SiDu01/MakroPad/hardware/case/README.md

# MakroPad Gehäuse

Parametrisches OpenSCAD-Modell: [makropad_case.scad](makropad_case.scad).

- Deckel ca. 199 × 117 mm, 12° Neigung (vorne 17 mm, hinten 42 mm hoch), überstehender Rand 5 mm hoch.
- 16 Tasten im 5×4-Raster, oben rechts ersetzt das OLED einen 2×2-Block, 3 Slider rechts.
- Switches sitzen in einer 7.5 mm tiefen Mulde (eigenes Druckteil), sichtbar sind nur die Keycaps.
- Die Schale ist gegenüber dem Deckel eingezogen (8 mm seitlich, 5 mm vorne/hinten),
  darunter verjüngt sie sich in Facetten zu einer achteckigen Bodenfläche.
- OLED in einem keilförmigen Gehäuse auf dem 2×2-Block: Display steht 60° zum Tisch,
  ragt ca. 25 mm über den Deckel.
- Deckel 5 mm stark, Kanten rechtwinklig zur Oberfläche.
- ESP32 liegt quer unter den Slidern an der Rückwand, flach über dem Boden, USB-C geht rechts aus dem Gehäuse.

## Teile & Export

| Teil | Druckausrichtung |
| --- | --- |
| `lid` | Sichtseite auf dem Bett (automatisch flach gelegt) |
| `switch_plate` | Platte auf dem Bett |
| `tray` | Boden auf dem Bett |
| `oled_frame` | aufrecht, Zapfen auf dem Bett; z. B. Silk-Silber-PLA |
| Keycap ([makropad_keycap.scad](makropad_keycap.scad), 16×) | FDM: aufrecht, offene Unterseite auf dem Bett. SLA: 30–45° gekippt, Oberseite zur Plattform, Stützen nur an Kante/Innenwand |

```powershell
foreach ($p in "lid", "switch_plate", "tray", "oled_frame") {
  & "D:\Program Files\OpenSCAD\openscad.exe" -D "part=""$p""" -o "export\makropad_$p.stl" makropad_case.scad
}
```

`part` = `assembly` | `exploded` | `lid` | `switch_plate` | `tray` | `oled_frame`.
Keycap (MX-Kreuz, blanko, flach mit leichter Mulde), `printer` = `fdm` | `sla` wählt das Spiel im Kreuz:

```powershell
foreach ($p in "fdm", "sla") {
  & "D:\Program Files\OpenSCAD\openscad.exe" -D "printer=""$p""" -o "export\makropad_keycap_$p.stl" makropad_keycap.scad
}
```

Sitzt die Kappe zu stramm oder zu locker, `cross_fdm` bzw. `cross_sla` anpassen.
FDM zeigt auf der gewölbten Oberseite Schichtstufen; für eine glatte Oberfläche SLA nehmen
(zähes oder ABS-ähnliches Resin, Kreuz vor dem Nachhärten freimachen).

Alle Maße stehen oben in der Datei (im OpenSCAD-Customizer editierbar).
Werte mit `NACHMESSEN` sind Annahmen.

Keines der Teile braucht Stützen. PLA/PETG, 0.2 mm Schicht, 3–4 Wände
(die Switch-Clips halten an 1.5 mm Plattenstärke).

## Montage

1. Switches von oben in die Switch-Platte klicken.
2. Switch-Platte von unten in den Deckel setzen, 4× M2×6 durch die Laschen in den Deckel.
3. OLED kopfüber einbauen (Anschlüsse unten, die Firmware dreht das Bild per
   `config::OledRotation`): von unten in das Display-Gehäuse führen, an die schräge
   Fläche legen und ca. 2,5 mm nach oben schieben, bis der obere Platinenrand unter
   der Haltelippe steckt. Unten mit 2× M1.7×4 durch die Platine verschrauben
   (Schraubendreher schräg von unten durch die offene Unterseite).
   Keine Stiftleiste auf der Display-Seite → Kabel direkt anlöten, sie laufen nach unten raus.
   Rahmen samt Display von oben in den Deckel setzen und mit 2× M1.7×5 von unten durch
   die Auflage im Deckel verschrauben.
4. Slider-Module von unten an die Abstandshalter schrauben (M3, selbstschneidend).
   Das Poti sitzt außermittig: der schmale 2-mm-Rand neben dem Poti zeigt nach rechts
   (zur Außenkante), sonst trifft der Hebel den Schlitz nicht.
   Stiftleisten möglichst seitlich/abgewinkelt, nach unten ist wenig Platz.
5. ESP32 (64 × 28 mm, schmales Ende 18 mm) ohne Stiftleisten: Kabel direkt in die Lötaugen
   löten, Lötstellen unten max. 1,5 mm. Board in die Halterung unter den Slidern legen,
   USB-C zur rechten Seitenwand, das schmale Ende links in den Anschlag. Über dem Board
   bleiben ca. 10 mm bis zur Unterseite der Slider-Module.
6. Deckel aufsetzen, bis die 4 Schnapphaken (rechts und hinten) einrasten, dann
   5× M2×10 Zylinderkopf (DIN 912) von unten durch die Kanäle der Schale in die Dome
   am Deckel schrauben (vorne links, hinten links, vorne und hinten zwischen Tasten und
   Slidern, hinten neben dem OLED).
