SiDu01/MakroPad/graphify-out/GRAPH_REPORT.md

# Graph Report - MakroPad  (2026-11-03)

## Corpus Check
- 133 files · ~69,151 words
- Verdict: corpus is large enough that graph structure adds value.

## Summary
- 3484 nodes · 4950 edges · 336 communities (242 shown, 94 thin omitted)
- Extraction: 98% EXTRACTED · 2% INFERRED · 0% AMBIGUOUS · INFERRED: 88 edges (avg confidence: 0.8)
- Token cost: 0 input · 0 output

## Graph Freshness
- Built from commit: `afa39b66`
- Run `git rev-parse HEAD` and compare to check if the graph is stale.
- Run `graphify update .` after code changes (no API cost).

## Community Hubs (Navigation)
- [[_COMMUNITY_Community 0|Community 0]]
- [[_COMMUNITY_Community 1|Community 1]]
- [[_COMMUNITY_Community 3|Community 3]]
- [[_COMMUNITY_Community 4|Community 4]]
- [[_COMMUNITY_Community 6|Community 6]]
- [[_COMMUNITY_Community 7|Community 7]]
- [[_COMMUNITY_Community 8|Community 8]]
- [[_COMMUNITY_Community 9|Community 9]]
- [[_COMMUNITY_Community 10|Community 10]]
- [[_COMMUNITY_Community 11|Community 11]]
- [[_COMMUNITY_Community 12|Community 12]]
- [[_COMMUNITY_Community 14|Community 14]]
- [[_COMMUNITY_Community 17|Community 17]]
- [[_COMMUNITY_Community 18|Community 18]]
- [[_COMMUNITY_Community 19|Community 19]]
- [[_COMMUNITY_Community 20|Community 20]]
- [[_COMMUNITY_Community 21|Community 21]]
- [[_COMMUNITY_Community 22|Community 22]]
- [[_COMMUNITY_Community 23|Community 23]]
- [[_COMMUNITY_Community 24|Community 24]]
- [[_COMMUNITY_Community 25|Community 25]]
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
3. `ShellViewModel` - 80 edges
4. `IdleScreensEditorViewModel` - 53 edges
5. `PadViewModel` - 52 edges
6. `MakroPadRuntime` - 42 edges
7. `SerialMakroPadConnection` - 39 edges
8. `DisplaySettingsViewModel` - 37 edges
9. `App` - 36 edges
10. `BindingInspectorViewModel` - 32 edges

## Surprising Connections (you probably didn't know these)
- `MakroPad Firmware` --semantically_similar_to--> `ESP32-S3 Firmware`  [INFERRED] [semantically similar]
  firmware/MakroPadFirmware/README.md → README.md
- `IdleScreenOrchestrator` --references--> `DateTime`  [EXTRACTED]
  legacy/app/MakroPad.App/Services/IdleScreenOrchestrator.cs → app/MakroPad.Core/Display/OledMirror.cs
- `SerialMakroPadConnection` --references--> `SerialPort`  [EXTRACTED]
  legacy/app/MakroPad.Device/SerialMakroPadConnection.cs → app/MakroPad.Device/SerialLineTransport.cs
- `MainWindowViewModel` --references--> `IReadOnlyDictionary`  [EXTRACTED]
  app/MakroPad.App/ViewModels/MainWindowViewModel.cs → legacy/app/MakroPad.App/Services/ActionDefinitionCatalog.cs
- `MainWindowViewModel` --references--> `SimulatedMakroPadConnection`  [EXTRACTED]
  app/MakroPad.App/ViewModels/MainWindowViewModel.cs → legacy/app/MakroPad.App/Services/DeviceSessionService.cs

## Hyperedges (group relationships)
- **Serial Handshake Flow** — protocol_hello_message, protocol_hello_ack_message, app_readme_serial_connection, firmware_readme_makropad_firmware [EXTRACTED 1.00]
- **Input to Action Flow** — hardware_buttons_gpio_pullup, hardware_sliders_adc1, protocol_button_message, protocol_slider_message, app_readme_action_pipeline [EXTRACTED 1.00]
- **OLED Display Configuration Flow** — hardware_oled_i2c_ssd1306, protocol_display_message, protocol_config_message, protocol_action_result_message, app_readme_oled_default_screen [EXTRACTED 1.00]

## Communities (336 total, 94 thin omitted)

### Community 0 - "Community 0"
Cohesion: 0.18
Nodes (19): OLED Default Screen, ActiveSliderCount, Adafruit GFX Library, Adafruit SSD1306 Library, MakroPad Firmware, Wire Library, Buttons GPIO INPUT_PULLUP Wiring, ESP32-S3-DevKitC-1 (+11 more)

### Community 1 - "Community 1"
Cohesion: 0.03
Nodes (34): ActionPipeline, ActionDefinitionCatalog, ActionPipeline, BindingEditorService, bool, CancellationTokenSource, DeviceDisplaySyncService, DeviceSessionService (+26 more)

### Community 3 - "Community 3"
Cohesion: 0.08
Nodes (21): CancellationTokenSource, DeviceConnectionState, int, object, TimeSpan, DateTimeOffset, CancellationTokenSource, DateTimeOffset (+13 more)

### Community 4 - "Community 4"
Cohesion: 0.06
Nodes (25): bool, DateTime, double, uint, bool, DateTime, int, long (+17 more)

### Community 6 - "Community 6"
Cohesion: 0.18
Nodes (11): button, code:text (button;id=1;state=down), code:text (slider;id=1;value=1834;raw=1841), code:text (error;code=display_init_failed;message=OLED%20not%20found), code:text (hello;proto=1;fw=0.1.0;device=makropad-s3;buttons=20;sliders), code:text (ready;uptime=1240), error, ESP -> App Nachrichten (+3 more)

### Community 7 - "Community 7"
Cohesion: 0.11
Nodes (16): IApplicationVolumeController, IKeyboardController, ISystemLauncher, ISystemMediaController, ISystemVolumeController, IApplicationVolumeController, IKeyboardController, ISystemLauncher (+8 more)

### Community 8 - "Community 8"
Cohesion: 0.23
Nodes (3): string, DisplayTriggerNormalizer, string

### Community 9 - "Community 9"
Cohesion: 0.12
Nodes (10): DiagnosticsView, DiagnosticsView, UserControl, DebugView, DeviceView, DiagnosticsView, DisplayEditorView, DisplayInspectorView (+2 more)

### Community 10 - "Community 10"
Cohesion: 0.21
Nodes (3): ProfileConfigService, ProfileConfigServiceTests, ProfileConfigService

### Community 11 - "Community 11"
Cohesion: 0.19
Nodes (5): IKeyboardController, FakeApplicationVolumeController, FakeKeyboardController, FakeSystemLauncher, FakeVolumeController

### Community 12 - "Community 12"
Cohesion: 0.13
Nodes (10): Dictionary, uint, ushort, Dictionary, uint, ushort, Dictionary, uint (+2 more)

### Community 14 - "Community 14"
Cohesion: 0.06
Nodes (27): bool, ConfigService, App, MakroPadRuntime, string, TrayIcon, Application, AssignWindow (+19 more)

### Community 18 - "Community 18"
Cohesion: 0.09
Nodes (17): bool, DateTime, Func, int, IProcessPresenceProbe, ISystemStateProvider, DispatcherTimer, IdleScreenConfig (+9 more)

### Community 19 - "Community 19"
Cohesion: 0.14
Nodes (10): ActionExecutor, ActionResolver, Dictionary, int, TimeSpan, Dictionary, TimeSpan, ActionPipeline (+2 more)

### Community 21 - "Community 21"
Cohesion: 0.14
Nodes (13): BindingEditorService, bool, MakroPadConfig, ProfileConfigService, string, BindingViewModel, BindingEditorService, bool (+5 more)

### Community 22 - "Community 22"
Cohesion: 0.05
Nodes (17): DeviceDisplaySyncService, Func, object, DisplayTriggerRuntimeState, Func, IDisplayTriggerSink, ISystemLauncher, DeviceDisplaySyncService (+9 more)

### Community 23 - "Community 23"
Cohesion: 0.24
Nodes (4): int, int, int, MakroPadDeviceProbe

### Community 24 - "Community 24"
Cohesion: 0.14
Nodes (5): AssignWindow, MainWindow, MainWindow, Shell, Window

### Community 26 - "Community 26"
Cohesion: 0.22
Nodes (5): string, INowPlayingProvider, string, string, ProcessWindowNowPlayingProvider

### Community 28 - "Community 28"
Cohesion: 0.10
Nodes (7): Func, JsonSerializerOptions, JsonFileStore, CreateDefault(), MakroPadConfigStore, JsonSerializerOptions, JsonSerializerOptions

### Community 30 - "Community 30"
Cohesion: 0.60
Nodes (3): Executed(), Throttled(), Unbound()

### Community 44 - "Community 44"
Cohesion: 1.00
Nodes (3): ActionDefinition Metadata Model, Config Editor Parameter Hints, Structured Action Controls

### Community 45 - "Community 45"
Cohesion: 0.12
Nodes (9): ActionDefinitionCatalog, BindingEditorService, bool, string, ActionDefinitionCatalog, BindingEditorService, bool, string (+1 more)

### Community 46 - "Community 46"
Cohesion: 0.11
Nodes (12): bool, CancellationTokenSource, int, object, Task, Channel, Decoder, GattCharacteristic (+4 more)

### Community 63 - "Community 63"
Cohesion: 0.08
Nodes (25): Board-Revision pruefen, Buttons, Buttons, Buttons, Buttons, code:text (GPIO ---- Switch ---- GND), code:text (3V3 ---- Potentiometer Ende 1), code:text (OLED VCC -> 3V3) (+17 more)

### Community 64 - "Community 64"
Cohesion: 0.12
Nodes (16): Bekannte Anforderungen, code:text (hello;fw=0.1.0;device=makropad-s3), code:text (display;mode=media;artist=Daft Punk;title=Digital Love), code:json ({), code:text (MakroPad/), Desktop Companion App, Empfohlene Architektur, Empfohlener erster Meilenstein (+8 more)

### Community 65 - "Community 65"
Cohesion: 0.12
Nodes (15): App-disconnected HID fallback, code:text (hello;proto=1;fw=0.2.0;device=makropad-s3;buttons=20;sliders), code:text (hello-ack;proto=1;app=manual), code:text (ping;id=1), code:text (pong;id=1), code:text (display;mode=message;text=Hello%20MakroPad), code:text (config;profile=Default;actionResultTimeoutMs=3000;preferredD), code:text (button;id=1;state=down) (+7 more)

### Community 66 - "Community 66"
Cohesion: 0.18
Nodes (10): code:powershell (dotnet build app\MakroPad.sln), Current State, Graphify Notes, Known Limitations, MakroPad Handoff, OLED Behavior, Recent Milestones, Recommended Next Steps (+2 more)

### Community 67 - "Community 67"
Cohesion: 0.18
Nodes (10): Abschlussformat, code:powershell (dotnet build app\MakroPad.sln), code:powershell (pio run), Entwicklung, Git, graphify, MakroPad Agent Workflow, Projektfokus (+2 more)

### Community 69 - "Community 69"
Cohesion: 0.18
Nodes (10): Aktuelle Grenzen, App-Verhalten, code:text (display;mode=layout;layout=volume;durationMs=1500;title=Volu), code:text (Volume), Display Design, Idle-Screen-Aktivierung, Naechste Ausbaustufen, Prinzip (+2 more)

### Community 70 - "Community 70"
Cohesion: 0.33
Nodes (5): Config Editor Parameter Hints, Handoff, Now Playing, Technical Debt, TODO

### Community 71 - "Community 71"
Cohesion: 0.33
Nodes (6): Aufbau, Bauen und testen, code:powershell (# Firmware (im Ordner firmware/)), Current Status, MakroPad, Status

### Community 88 - "Community 88"
Cohesion: 0.09
Nodes (8): int, string, string, DisplayTriggerRenderer, DisplayTriggerRenderer, ListContext, int, string

### Community 90 - "Community 90"
Cohesion: 0.06
Nodes (12): uint, ushort, ISystemMediaController, uint, ushort, NoopSystemMediaController, ActionPipelineTests, FakeMediaController (+4 more)

### Community 92 - "Community 92"
Cohesion: 0.06
Nodes (15): IApplicationVolumeController, string, bool, DeviceDisplaySyncService, int, NowPlayingTrack, string, IApplicationVolumeController (+7 more)

### Community 98 - "Community 98"
Cohesion: 0.22
Nodes (5): Dictionary, object, DisplayTriggerInputTracker, Dictionary, object

### Community 100 - "Community 100"
Cohesion: 0.11
Nodes (8): SemaphoreSlim, string, SemaphoreSlim, string, MakroPadDeviceProbe, SerialMakroPadConnection, DeviceSessionService, SimulatedMakroPadConnection

### Community 104 - "Community 104"
Cohesion: 0.18
Nodes (3): BindingEditorService, BindingEditorService, BindingEditorServiceTests

### Community 105 - "Community 105"
Cohesion: 0.33
Nodes (5): ActionDefinitionCatalog, ActionDefinitionCatalog, BindingEditorService, Failed(), Succeeded()

### Community 106 - "Community 106"
Cohesion: 0.22
Nodes (3): ProtocolInputDecoder, ProtocolInputDecoderTests, ProtocolInputDecoder

### Community 107 - "Community 107"
Cohesion: 0.25
Nodes (5): SemaphoreSlim, SemaphoreSlim, MakroPadConfigStore, SemaphoreSlim, MakroPadConfigService

### Community 108 - "Community 108"
Cohesion: 0.29
Nodes (4): IReadOnlyList, IReadOnlyDictionary, IReadOnlyList, ActionDefinitionCatalog

### Community 124 - "Community 124"
Cohesion: 0.14
Nodes (6): BLECharacteristicCallbacks, BLEServerCallbacks, connected(), RxCallbacks, ServerCallbacks, write()

### Community 125 - "Community 125"
Cohesion: 0.06
Nodes (6): string, ConfigServiceTests, ConfigValidatorTests, ProfileManagerTests, ShortcutParserTests, ProfileConfig

### Community 126 - "Community 126"
Cohesion: 0.13
Nodes (13): Build, code:text (%APPDATA%\MakroPad\config.json), code:text (hello-ack;proto=1;app=0.1.0), code:powershell (dotnet build app\MakroPad.sln), code:powershell (dotnet test app\MakroPad.sln), Current Prototype, MakroPad App, MakroPad.App Project (+5 more)

### Community 130 - "Community 130"
Cohesion: 0.20
Nodes (7): ActionPipeline, DeviceSessionService, DisplayTriggerOrchestrator, ActionPipeline, DeviceSessionService, DisplayTriggerOrchestrator, ActionFeedbackCoordinator

### Community 132 - "Community 132"
Cohesion: 0.04
Nodes (32): ActionFeedbackCoordinator, ActionDefinitionCatalog, ActionPipeline, BindingEditorService, bool, DeviceDisplaySyncService, DeviceSessionService, DisplayTriggerOrchestrator (+24 more)

### Community 133 - "Community 133"
Cohesion: 0.33
Nodes (3): int, int, EventLogService

### Community 137 - "Community 137"
Cohesion: 0.12
Nodes (11): bool, CancellationTokenSource, DisplayTriggerInputTracker, IDisplayTriggerSink, object, DisplayTriggerInputTracker, bool, CancellationTokenSource (+3 more)

### Community 139 - "Community 139"
Cohesion: 0.06
Nodes (8): ISystemVolumeController, NoopSystemVolumeController, WindowsSystemVolumeController, DeviceDisplaySyncServiceTests, FakeSystemVolumeController, RecordingConnection, DisplaySettingsViewModelTests, FakeSystemVolumeController

### Community 140 - "Community 140"
Cohesion: 0.09
Nodes (15): Handler, ProfileActions, bool, HashSet, int, object, uint, ushort (+7 more)

### Community 141 - "Community 141"
Cohesion: 0.50
Nodes (5): MakroPad.Device Project, Serial Connection, Simulator Connection, hello-ack Message, hello Message

### Community 142 - "Community 142"
Cohesion: 0.17
Nodes (10): DateTimeOffset, ILineTransport, int, ITimer, object, string, TimeProvider, TimeSpan (+2 more)

### Community 144 - "Community 144"
Cohesion: 0.20
Nodes (7): bool, ConfigSession, string, ObservableObject, DisplayInspectorViewModel, GestureTabViewModel, InputSwitchViewModel

### Community 145 - "Community 145"
Cohesion: 0.06
Nodes (19): bool, ConfigSession, Func, int, List, MakroPadRuntime, SimulatedDevice, string (+11 more)

### Community 147 - "Community 147"
Cohesion: 0.14
Nodes (9): Action, bool, double, string, Action, bool, double, string (+1 more)

### Community 149 - "Community 149"
Cohesion: 0.17
Nodes (15): Build and Test Workflow, German Collaboration Rules, Git Commit Workflow, MakroPad Agent Workflow, Repository Editing Rules, Firmware and Desktop App Architecture, Avalonia UI Technology Choice, Hardware Layout Configuration (+7 more)

### Community 150 - "Community 150"
Cohesion: 0.11
Nodes (9): Action, bool, int, string, Action, bool, int, string (+1 more)

### Community 151 - "Community 151"
Cohesion: 0.07
Nodes (17): bool, DisplayBlockViewModel, HashSet, int, IReadOnlyList, string, DisplayBlockViewModel, DisplayTriggerPreset (+9 more)

### Community 155 - "Community 155"
Cohesion: 0.10
Nodes (8): uint, IForegroundWindowProbe, ISystemMetricsSampler, uint, FakeForegroundProbe, FakeMetricsSampler, SystemStateProviderTests, WindowsForegroundWindowProbe

### Community 158 - "Community 158"
Cohesion: 0.09
Nodes (12): bool, DisplayBlockViewModel, int, NowPlayingTrack, OledDefaultScreenRenderer, string, IdleScreenItemViewModel, bool (+4 more)

### Community 159 - "Community 159"
Cohesion: 0.08
Nodes (14): IForegroundWindowProbe, ISystemMetricsSampler, HashSet, IProcessPresenceProbe, IReadOnlySet, ISystemStateProvider, IForegroundWindowProbe, ISystemMetricsSampler (+6 more)

### Community 166 - "Community 166"
Cohesion: 0.09
Nodes (8): IActionHandler, HttpRequestAction, TimeSpan, int, RecordingAction, KeyboardShortcutAction, MediaKeyAction, SystemVolumeAction

### Community 167 - "Community 167"
Cohesion: 0.17
Nodes (6): ISystemVolumeController, OledDefaultScreenRenderer, DeviceConfigMessageBuilder, ISystemVolumeController, OledDefaultScreenRenderer, DeviceDisplaySyncService

### Community 168 - "Community 168"
Cohesion: 0.24
Nodes (5): INowPlayingProvider, string, INowPlayingProvider, string, NowPlayingViewModel

### Community 170 - "Community 170"
Cohesion: 0.09
Nodes (22): code:text (1  2  3  ·  ·), code:text (MakroPad/), code:text (DeviceService ──InputEvent──▶ InputRouter ──Binding──▶ Actio), Leitlinie, M0 – Grundgerüst, M1 – Vertikaler Durchstich, M2 – Profile, Bindings, Actions, M3 – Bedienoberfläche (+14 more)

### Community 174 - "Community 174"
Cohesion: 0.12
Nodes (5): MakroPadConfig, ProfileManager, AutoProfileSwitcher, AutoProfileSwitcherTests, ProfileRuleEditingTests

### Community 179 - "Community 179"
Cohesion: 0.18
Nodes (6): Action, Action, string, Action, string, DisplayBlockViewModel

### Community 181 - "Community 181"
Cohesion: 0.18
Nodes (6): bool, ConfigSession, IForegroundSource, string, FallbackOption, AutoProfileViewModel

### Community 182 - "Community 182"
Cohesion: 0.20
Nodes (5): ActionOption, int, MacroStep, MacroStepViewModel, ParameterFactory

### Community 184 - "Community 184"
Cohesion: 0.33
Nodes (7): bool, string, bool, string, KeyViewModel, PadSlotViewModel, SliderViewModel

### Community 188 - "Community 188"
Cohesion: 0.19
Nodes (6): DispatcherTimer, IFilePicker, IShortcutRecorder, MakroPadRuntime, TimeSpan, BindingInspectorViewModel

### Community 189 - "Community 189"
Cohesion: 0.15
Nodes (14): App → Gerät, code:text (type;key=value;key=value), code:text (hello;proto=2;fw=0.5.0;device=makropad;buttons=16;sliders=3;), code:text (hello-ack;proto=2;app=0.5.0), code:text (Volume=50%), Format, Gerät → App, Grundsätze (+6 more)

### Community 190 - "Community 190"
Cohesion: 0.18
Nodes (11): Beispielablauf, code:text (error;code=unsupported_protocol;message=Expected%20proto%3D1), code:text (ESP -> App: hello;proto=1;fw=0.1.0;device=makropad-s3;button), code:text (ping;id=42), Fehlerbehandlung, Heartbeat, Offene Entscheidungen, Serial Protocol (+3 more)

### Community 191 - "Community 191"
Cohesion: 0.29
Nodes (4): Func, KeyViewModel, IFlushable, KeyInspectorViewModel

### Community 192 - "Community 192"
Cohesion: 0.20
Nodes (10): action-result, App -> ESP Nachrichten, code:text (hello-ack;proto=1;app=0.1.0), code:text (display;mode=profile;name=Gaming), code:text (config;profile=Default;actionResultTimeoutMs=3000;preferredD), code:text (action-result;input=button:1;status=ok;message=Muted), code:text (action-result;input=button:1;status=ok;message=Play%2FPause), config (+2 more)

### Community 195 - "Community 195"
Cohesion: 0.22
Nodes (8): 1. Wo der Fokus verloren ging, 2. Kern – übernehmen (Idee und meist auch Logik), 3. Gute Ideen – stark vereinfacht übernehmen, 4. Streichen bzw. bewusst nicht wieder bauen, 5. Lehren für die Architektur des Neubaus, 6. Entscheidungen (2026-10-04), Neuentwicklung – Bestandsaufnahme, Stack-Begründung (Kurzfassung)

### Community 198 - "Community 198"
Cohesion: 0.15
Nodes (7): MakroPadRuntime, SimulatedDevice, TimeSpan, ConcurrentQueue, IAsyncLifetime, SimulatorRuntimeTests, RecordingAction

### Community 200 - "Community 200"
Cohesion: 0.33
Nodes (5): code:powershell (foreach ($p in "lid", "switch_plate", "tray", "oled_frame") ), code:powershell (foreach ($p in "fdm", "sla") {), MakroPad Gehäuse, Montage, Teile & Export

### Community 201 - "Community 201"
Cohesion: 0.50
Nodes (3): sdk, rollForward, version

### Community 202 - "Community 202"
Cohesion: 0.16
Nodes (4): poll(), readSliderRaw(), loop(), sendHello()

### Community 204 - "Community 204"
Cohesion: 0.67
Nodes (3): code:text (hello;proto=1;fw=0.1.0;device=makropad-s3;buttons=20;sliders), code:text (hello-ack;proto=1;app=0.1.0), Verbindungsaufbau

### Community 205 - "Community 205"
Cohesion: 0.16
Nodes (7): bool, int, object, SerialPort, SerialLineTransport, SerialPort, Thread

### Community 239 - "Community 239"
Cohesion: 0.29
Nodes (4): ConfigSession, Dictionary, string, AssignDialogViewModel

### Community 240 - "Community 240"
Cohesion: 0.08
Nodes (22): ActionRunner, ActionRunner, CancellationTokenSource, DeviceSession, GestureDetector, IDeviceConnector, InputRouter, int (+14 more)

### Community 241 - "Community 241"
Cohesion: 0.10
Nodes (34): applyState(), clearOverlay(), contentChanged(), drawHeader(), drawIcon(), drawIdle(), drawOverlay(), drawProgressBar() (+26 more)

### Community 242 - "Community 242"
Cohesion: 0.14
Nodes (6): cp437For(), marqueeCycle(), marqueeWindow(), utf8ToCp437(), test_marquee_window(), test_utf8_umlauts_map_to_cp437()

### Community 243 - "Community 243"
Cohesion: 0.12
Nodes (6): ConfigService, int, MakroPadRuntime, SimulatedDevice, string, MainViewModel

### Community 244 - "Community 244"
Cohesion: 0.12
Nodes (6): DeviceSession, FakeTimeProvider, string, DeviceSessionTests, FakeTimeProvider, FakeTransport

### Community 245 - "Community 245"
Cohesion: 0.13
Nodes (9): string, ConfigValidator, feed(), get(), getInt(), hexValue(), parse(), percentDecode() (+1 more)

### Community 247 - "Community 247"
Cohesion: 0.15
Nodes (8): object, string, Timer, TimeSpan, ConfigService, FileSystemWatcher, JsonFileStore, Timer

### Community 248 - "Community 248"
Cohesion: 0.21
Nodes (4): int, SimulatedDevice, Transport, Transport

### Community 249 - "Community 249"
Cohesion: 0.25
Nodes (7): active(), FallbackKey, label, usage, onButton(), onSlider(), press()

### Community 250 - "Community 250"
Cohesion: 0.20
Nodes (3): int, string, DeviceMessages

### Community 253 - "Community 253"
Cohesion: 0.29
Nodes (5): frame(), place(), stub(), text(), uid()

### Community 254 - "Community 254"
Cohesion: 0.21
Nodes (5): HttpMessageHandler, Failing, FakeHandler, HttpRequestActionTests, Recorder

### Community 255 - "Community 255"
Cohesion: 0.29
Nodes (5): bool, Func, object, LatestWinsQueue, T

### Community 256 - "Community 256"
Cohesion: 0.38
Nodes (10): connected(), handleLine(), helloLine(), outputChannel(), poll(), send(), sendHello(), setConnected() (+2 more)

### Community 258 - "Community 258"
Cohesion: 0.27
Nodes (4): Dictionary, IReadOnlyList, object, InputRouter

### Community 260 - "Community 260"
Cohesion: 0.16
Nodes (5): DeviceConnectionState, IMakroPadConnection, DeviceConnectionState, DeviceConnectionState, SimulatedMakroPadConnection

### Community 261 - "Community 261"
Cohesion: 0.40
Nodes (3): bool, GestureDetector, GestureDetectorTests

### Community 262 - "Community 262"
Cohesion: 0.47
Nodes (3): daysInMonth(), read(), set()

### Community 263 - "Community 263"
Cohesion: 0.08
Nodes (22): bool, ConfigSession, Func, IFilePicker, int, IShortcutRecorder, MakroPadRuntime, object (+14 more)

### Community 264 - "Community 264"
Cohesion: 0.31
Nodes (4): ActionRunner, Dictionary, TimeProvider, ConditionalWeakTable

### Community 274 - "Community 274"
Cohesion: 0.11
Nodes (7): InputRouter, Binding, ActionRunnerTests, FeedbackBuilderTests, InputRouterTests, LatestWinsQueueTests, ThrowingAction

### Community 275 - "Community 275"
Cohesion: 0.22
Nodes (5): bool, CancellationTokenSource, bool, CancellationTokenSource, AppRuntimeLoopService

### Community 278 - "Community 278"
Cohesion: 0.32
Nodes (3): IReadOnlyList, object, ProfileManager

### Community 279 - "Community 279"
Cohesion: 0.14
Nodes (14): Abwechselnd, Aktionen, Aufbau, Automatischer Profilwechsel, code:jsonc ({), code:text (1  2  3  ·  ·), code:jsonc ({ "input": "button:9:long", "action": "macro", "parameters":), code:jsonc ({ "input": "button:4", "action": "toggle", "parameters": { ") (+6 more)

### Community 280 - "Community 280"
Cohesion: 0.23
Nodes (6): Dictionary, Func, object, TimeProvider, GestureDetector, KeyState

### Community 282 - "Community 282"
Cohesion: 0.15
Nodes (3): ShortcutParser, Dictionary, ushort

### Community 283 - "Community 283"
Cohesion: 0.38
Nodes (3): OpenAppAction, OpenUrlAction, Shell

### Community 284 - "Community 284"
Cohesion: 0.17
Nodes (5): BluetoothSupportTests, StubConnector, FallbackDeviceConnector, IDeviceConnector, BleDeviceConnector

### Community 286 - "Community 286"
Cohesion: 0.27
Nodes (9): button_number(), chamfer(), dist(), is_oled(), P(), teardrop(), text(), toward() (+1 more)

### Community 287 - "Community 287"
Cohesion: 0.07
Nodes (18): ParameterFactory, bool, Func, string, IShortcutRecorder, RecorderAdapter, InspectorTests, NoPicker (+10 more)

### Community 288 - "Community 288"
Cohesion: 0.25
Nodes (4): ActionCatalog, int, string, ParameterDefinition

### Community 289 - "Community 289"
Cohesion: 0.33
Nodes (3): TimeSpan, KeyboardTextAction, RunCommandAction

### Community 290 - "Community 290"
Cohesion: 0.20
Nodes (11): bool, double, int, string, double, DisplayElementViewModel, FaderViewModel, KeyViewModel (+3 more)

### Community 292 - "Community 292"
Cohesion: 0.18
Nodes (7): int, List, object, string, Timer, IForegroundSource, ForegroundWatcher

### Community 295 - "Community 295"
Cohesion: 0.15
Nodes (6): bool, ConfigSession, int, string, ThemeOption, SettingsViewModel

### Community 296 - "Community 296"
Cohesion: 0.24
Nodes (4): bool, DispatcherTimer, StyledProperty, OledView

### Community 298 - "Community 298"
Cohesion: 0.24
Nodes (3): bool, int, OledCanvas

### Community 299 - "Community 299"
Cohesion: 0.25
Nodes (3): FakeTimeProvider, OledMirrorTests, OledMirror

### Community 303 - "Community 303"
Cohesion: 0.25
Nodes (7): code:powershell (MakroPad.App.exe --simulator --config-dir <Ordner mit Beispi), Farben, Gestaltung der App, Idee, Regeln, Schrift, Screenshots für die Gestaltungsprüfung

### Community 304 - "Community 304"
Cohesion: 0.33
Nodes (3): Dictionary, int, DisplayText

### Community 305 - "Community 305"
Cohesion: 0.40
Nodes (3): ConfigService, MakroPadRuntime, ConfigSession

### Community 307 - "Community 307"
Cohesion: 0.40
Nodes (3): PadView, PadView, PadView

### Community 308 - "Community 308"
Cohesion: 0.21
Nodes (7): NowPlaying, object, Timer, TimeSpan, GlobalSystemMediaTransportControlsSession, GlobalSystemMediaTransportControlsSessionManager, MediaSessionWatcher

### Community 311 - "Community 311"
Cohesion: 0.40
Nodes (3): SettingsView, SettingsView, SettingsView

### Community 312 - "Community 312"
Cohesion: 0.50
Nodes (3): Adafruit GFX Library – 5x7 font (`app/MakroPad.Core/Display/GlcdFont.cs`), code:text (Software License Agreement (BSD License)), Third-party notices

### Community 315 - "Community 315"
Cohesion: 0.25
Nodes (5): HashSet, ProfileManager, string, AutoProfileSettings, AutoProfileSwitcher

### Community 316 - "Community 316"
Cohesion: 0.36
Nodes (4): ActionRunner, FakeTimeProvider, List, MacroRunnerTests

### Community 320 - "Community 320"
Cohesion: 0.24
Nodes (4): AppVolumeAction, AudioSessions, ForegroundVolumeAction, OtherAppsVolumeAction

### Community 321 - "Community 321"
Cohesion: 0.25
Nodes (3): FakeMedia, IForegroundSource, INowPlayingSource

### Community 323 - "Community 323"
Cohesion: 0.33
Nodes (3): StyledProperty, Control, FaderView

### Community 327 - "Community 327"
Cohesion: 0.36
Nodes (3): Func, TimeSpan, SerialDeviceConnector

### Community 328 - "Community 328"
Cohesion: 0.50
Nodes (3): antislop audit 001 (2026-10-28), Code (CLAUDE.md / ponytail), not antislop, Findings

### Community 330 - "Community 330"
Cohesion: 0.29
Nodes (7): Dual Serial Output, USB CDC Serial Role, error Message, JSON Lines Alternative, Version 1 Key-Value Protocol Format, Protocol Percent-Encoding, USB CDC Serial Transport

### Community 331 - "Community 331"
Cohesion: 0.29
Nodes (6): Bestellen (JLCPCB), code:powershell (& "D:\Program Files\KiCad\10.0\bin\python.exe" makropad_swit), Design Rules, Einbau, MakroPad Switch-Platine, Stecker J1 → ESP32-S3-DevKitC-1

### Community 332 - "Community 332"
Cohesion: 0.33
Nodes (6): Action Pipeline, MakroPad.Actions Project, Windows Media Actions, Windows Volume Actions, action-result Message, Supported Actions Catalog

### Community 335 - "Community 335"
Cohesion: 0.67
Nodes (4): Serial Heartbeat, Waiting for app Display State, ping Message, pong Message

## Knowledge Gaps
- **700 isolated node(s):** `PreToolUse`, `allow`, `PreToolUse`, `version`, `rollForward` (+695 more)
  These have ≤1 connection - possible missing edges or undocumented components.
- **94 thin communities (<3 nodes) omitted from report** — run `graphify query` to explore isolated nodes.

## Suggested Questions
_Questions this graph is uniquely positioned to answer:_

- **Why does `MainWindowViewModel` connect `Community 1` to `Community 2`, `Community 100`, `Community 132`, `Community 102`, `Community 167`, `Community 137`, `Community 107`, `Community 108`, `Community 13`, `Community 16`, `Community 21`, `Community 151`, `Community 92`, `Community 62`?**
  _High betweenness centrality (0.211) - this node is a cross-community bridge._
- **Why does `DisplayTriggerOrchestrator` connect `Community 137` to `Community 291`?**
  _High betweenness centrality (0.186) - this node is a cross-community bridge._
- **Why does `DisplayTriggerInputTracker` connect `Community 137` to `Community 1`?**
  _High betweenness centrality (0.183) - this node is a cross-community bridge._
- **What connects `PreToolUse`, `allow`, `PreToolUse` to the rest of the system?**
  _700 weakly-connected nodes found - possible documentation gaps or missing edges._
- **Should `Community 1` be split into smaller, more focused modules?**
  _Cohesion score 0.03305322128851541 - nodes in this community are weakly interconnected._
- **Should `Community 2` be split into smaller, more focused modules?**
  _Cohesion score 0.14408602150537633 - nodes in this community are weakly interconnected._
- **Should `Community 3` be split into smaller, more focused modules?**
  _Cohesion score 0.08 - nodes in this community are weakly interconnected._
