SiDu01/MakroPad/anti-slop/audit-001-2026-10-28.md

# antislop audit 001 (2026-10-28)

Scope: `app/` (Avalonia desktop app + Core), checked against the global CLAUDE.md, ponytail,
antislop core, antislop-ui and antislop-human. Firmware, case and installer not reviewed.

Direction: `docs/UI_DESIGN.md` (device colours, Bahnschrift, motion only on real input).
Design Read: desktop configurator for one hardware pad, device-as-front-panel language,
dial ENERGY 2 / RHYTHM 1 / MOTION 1. The direction is real and specific; no slop patterns from
Part 1 found (no gradients, glow, card grids, buzzwords, em dashes in UI text, fake data).

Build: `dotnet build MakroPad.sln` 0 warnings, 0 errors. Tests: 100/100 Core, 9/9 Device green.
Contrast: computed with `contrast-check.py` from the hex tokens in `Themes/Tokens.axaml`.
Not done: app not launched, no click-through, no keyboard walk-through (R-35 not met by this audit).

Web-only rules not applicable to a desktop app: R-03 (mobile), R-40, page semantics in R-39.

## Findings

| # | Prio | Rule | Where | Finding |
|---|---|---|---|---|
| 1 | HIGH | C-4 / data loss | `Services/ConfigSession.cs:31`, `Core/Configuration/ConfigService.cs:64` | If `config.json` has a JSON error, `Config` holds defaults and `LoadError` is set. Any edit in the UI then runs `Update` → `Save(defaults + edit)` and overwrites the user's file. `JsonFileStore` promises "a typo never wipes the user's work"; the app path breaks that. Fix: reject `Update` while `LoadError` is set (one guard, plus a test). |
| 2 | HIGH | R-25 (non-text 3:1) | `Themes/Styles.axaml:125`, `Tokens.axaml` `SelectionBrush` | Orange selection ring around a key sits on `LidWellBrush`: 1.16:1 light, 1.37:1 dark. Around OLED/fader on `LidBrush`: 1.51:1 light, 1.05:1 dark. Visible by hue only; fails for colour-blind users. |
| 3 | HIGH | R-32 (focus visible) | `Styles.axaml:180`, `:166` | Focus ring uses `InkBrush`. Dark theme on lid (OLED, faders): 2.40:1, below 3:1. In the key well: 3.12:1 dark (pass, tight), 5.05:1 light. |
| 4 | HIGH | R-25 (text 4.5:1) | `Views/PadView.axaml:88-89` | Key number and gesture hint use `KeycapNumberBrush` on the keycap: 2.46:1 light, 2.39:1 dark, at 11–12.5px. |
| 5 | MEDIUM | R-32 (unverified) | `Styles.axaml:37-58` | `Button.tab` replaces the whole template and has no `:focus-visible` style. Whether Fluent's focus adorner still shows was not checked in the running app. |
| 6 | LOW | R-25 (non-text) | `MainWindow.axaml:15`, `OfflineBrush` | Offline dot 2.42–2.73:1 light. Text next to it carries the state, so impact is small. |
| 7 | LOW | R-39 (state not colour-only) | `Views/KeyInspectorView.axaml:28` | "Gesture is bound" is a 6px orange dot only (3.17:1), no text or accessible name. |
| 8 | LOW | R-39 (cursor) | `Styles.axaml` | Only keycap/part buttons set `Cursor="Hand"`. Recommendation: do NOT change; arrow cursor on buttons is the Windows desktop convention, the rule is written for the web. |

## Code (CLAUDE.md / ponytail), not antislop

| # | Prio | Where | Finding |
|---|---|---|---|
| 9 | MEDIUM | `App.axaml.cs:388` | `DisposeAsync().AsTask().GetAwaiter().GetResult()` on the UI thread in `Shutdown`. CLAUDE.md forbids sync-over-async. Today safe (the runtime loop never `InvokeAsync`s to the UI thread), but one future `Dispatcher.InvokeAsync` in the loop deadlocks on exit. |
| 10 | LOW | `App.axaml.cs:58,194-208`, `InspectorViewModels.cs:58,91,106`, `ConfigEditor.cs:168,179`, `LatestWinsQueue.cs:64` | Null-forgiving `!` without a comment. `serial!` (line 58) can be `simulator as IDeviceConnector ?? serial` style without `!`; the rest are invariants worth one line each or a pattern match. |
| 11 | LOW | `App.axaml.cs:183-218, 333-408` | ~130 lines of developer self-test/screenshot code live in the production `App` class (incl. a `keybd_event` P/Invoke). Gated by debug mode, so not a risk, but it is half of `App.axaml.cs`. Candidate to move out, not urgent. |
| 12 | LOW | `ConfigService.cs:163` | `ArchiveLegacyConfig` `File.Move` can throw `IOException` (file locked) at startup, uncaught → app crash on launch. |
