SiDu01/MakroPad/hardware/case/export/preview_bottom.png

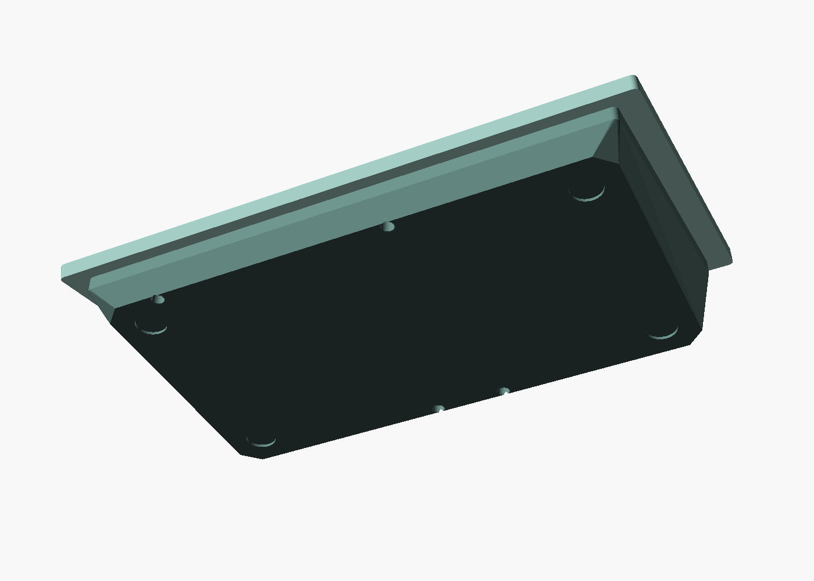
hardware/case/export/preview_bottom.png
