SiDu01/MakroPad/hardware/case/export/preview_closeup.png

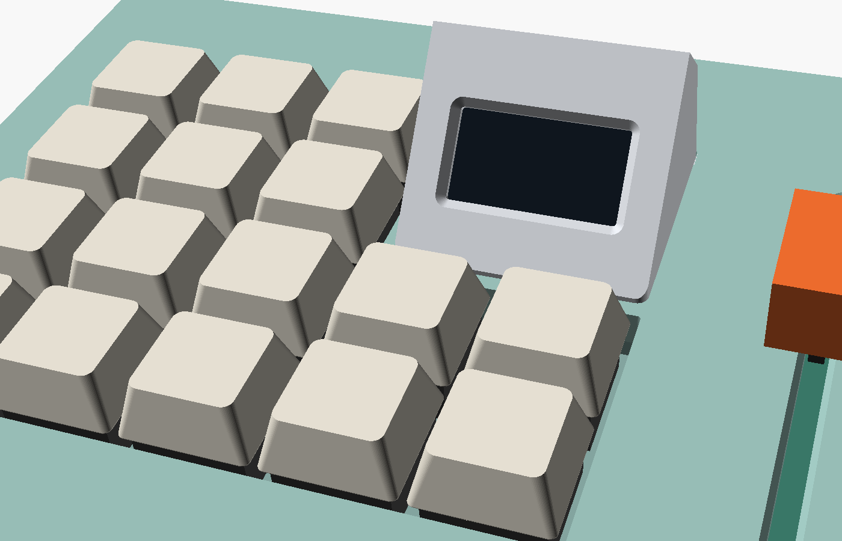
hardware/case/export/preview_closeup.png
