SiDu01/MakroPad/hardware/case/export/preview_esp.png

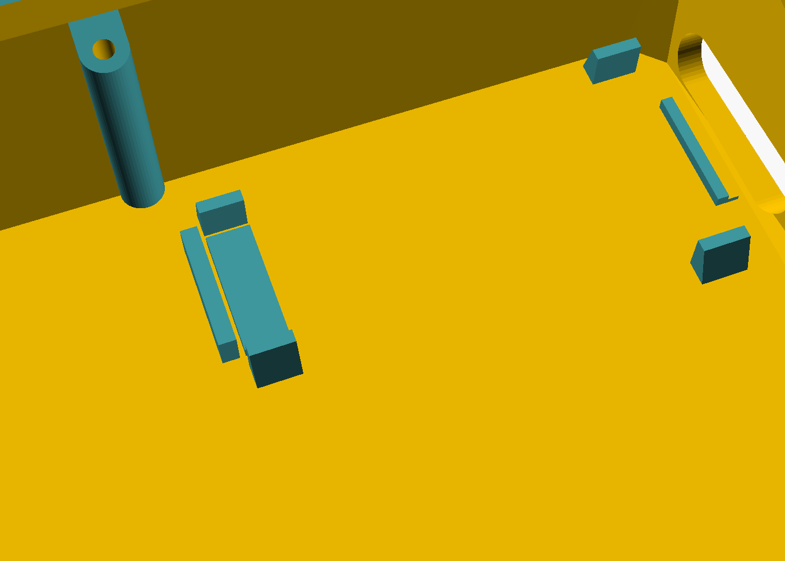
hardware/case/export/preview_esp.png
