SiDu01/MakroPad/hardware/case/export/preview_exploded.png

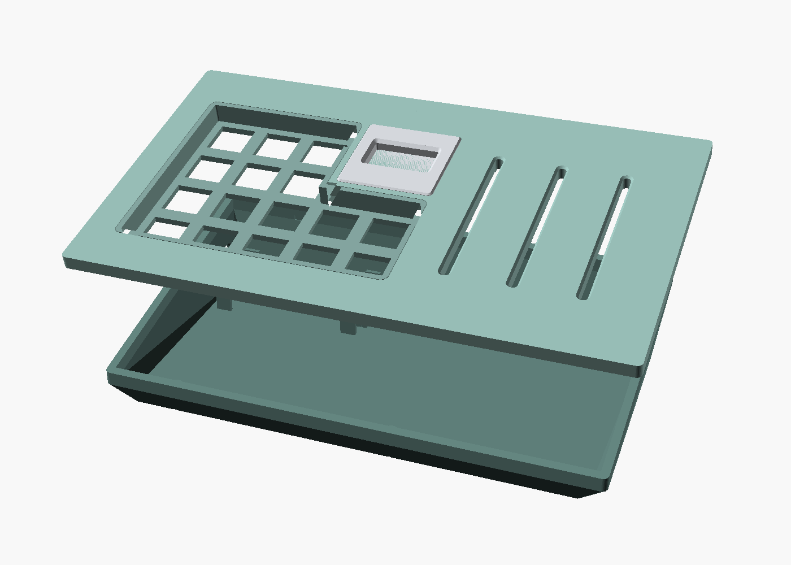
hardware/case/export/preview_exploded.png
