SiDu01/MakroPad/hardware/case/export/preview_keycap.png

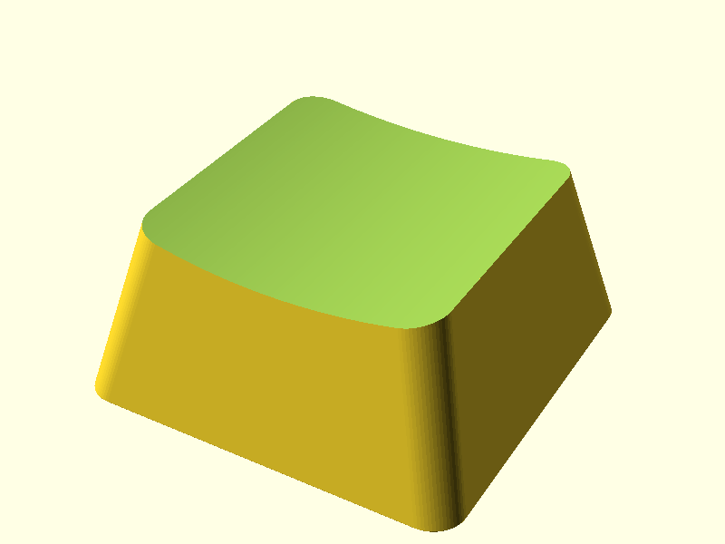
hardware/case/export/preview_keycap.png
