SiDu01/MakroPad/hardware/case/export/preview_oled_section.png

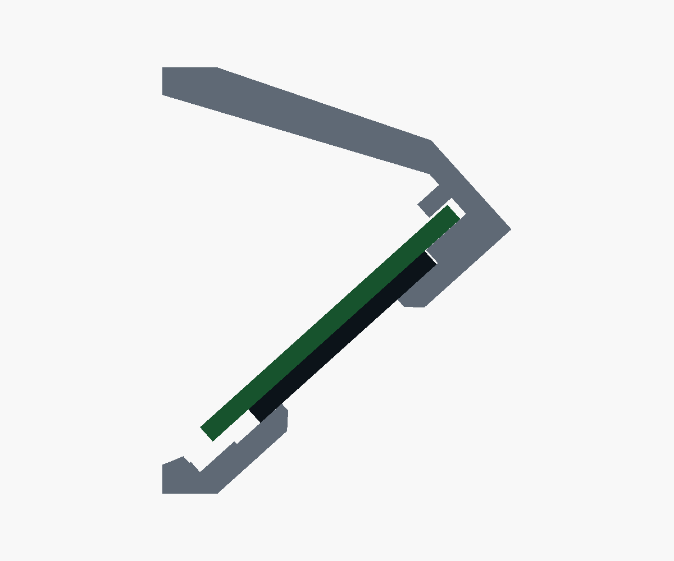
hardware/case/export/preview_oled_section.png
