SiDu01/MakroPad/hardware/case/export/preview_side.png

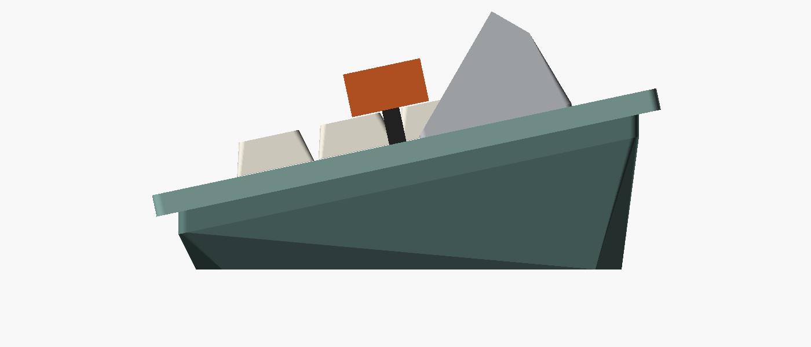
hardware/case/export/preview_side.png
