SiDu01/MakroPad/hardware/pcb/export/preview_pcb_top.png

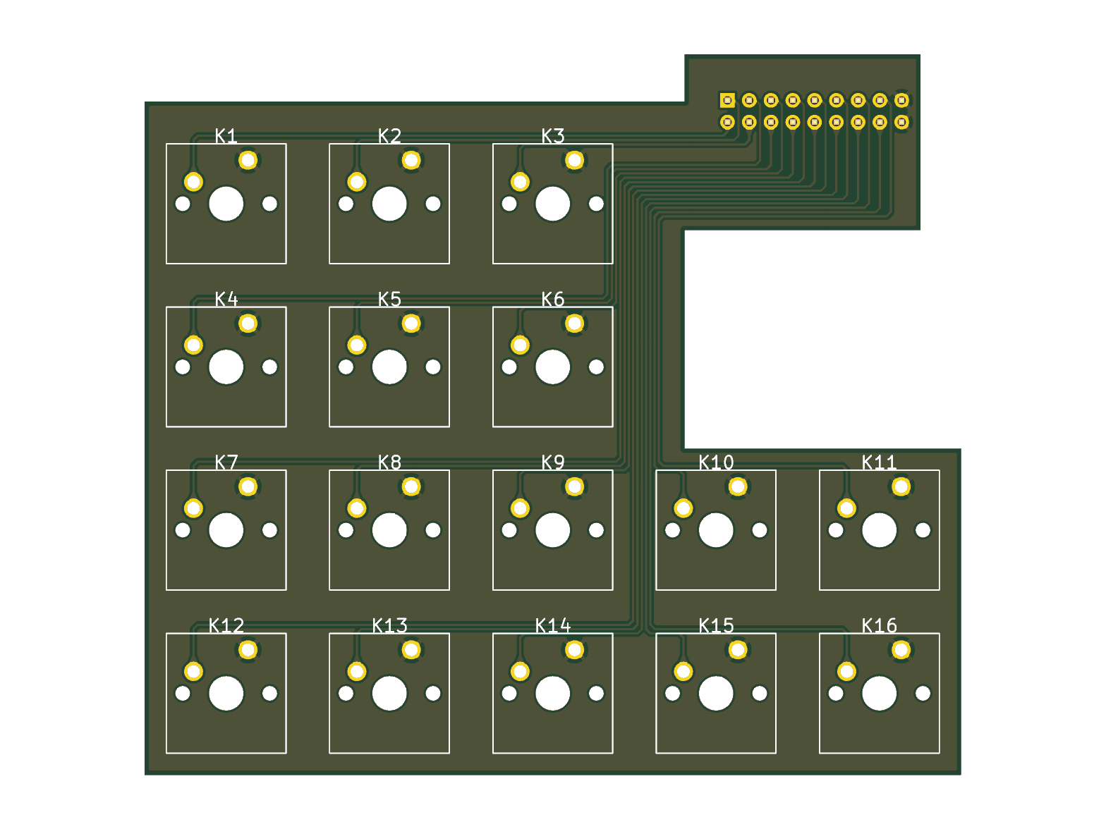
hardware/pcb/export/preview_pcb_top.png
