SiDu01/MakroPad/hardware/case/export/makropad_keycap_fdm.stl

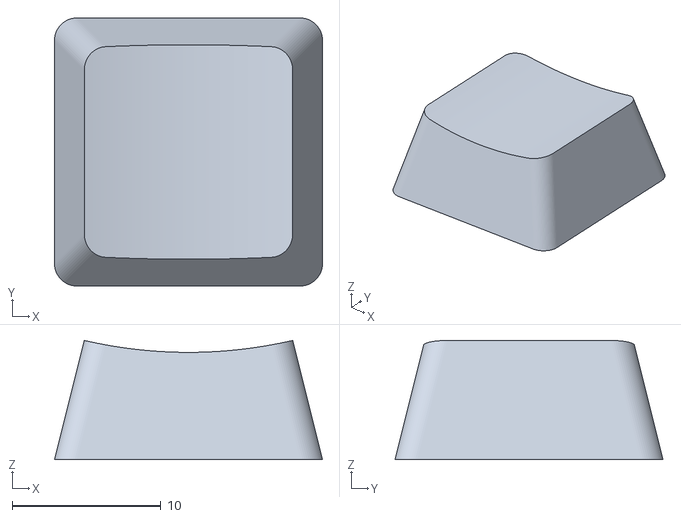
[picture p10: CAD file, 2026-10-31]
hardware/case/export/makropad_keycap_fdm.stl
18.0 x 18.0 x 8.00
