SiDu01/MakroPad/hardware/case/export/makropad_tray.stl

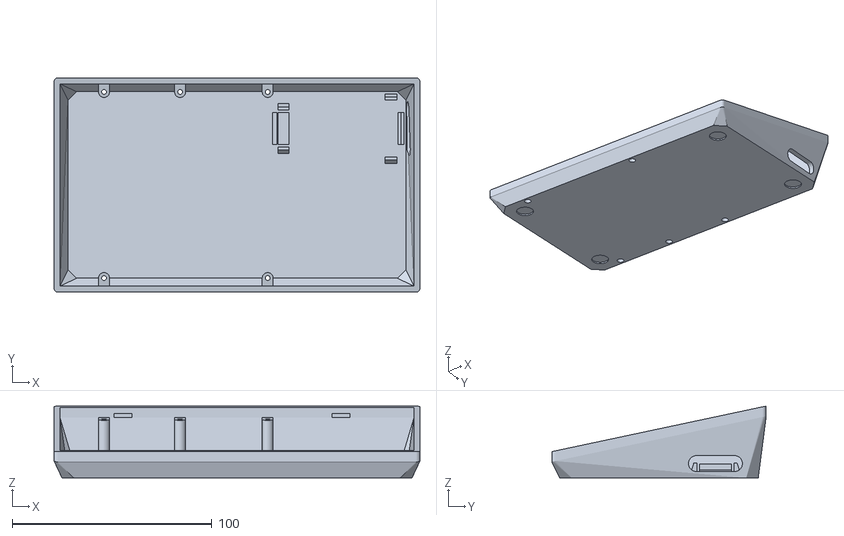
[picture p11: CAD file, 2026-10-31]
hardware/case/export/makropad_tray.stl
183.2 x 107.4 x 36.0
