SiDu01/MakroPad/hardware/case/export/makropad_lid.stl

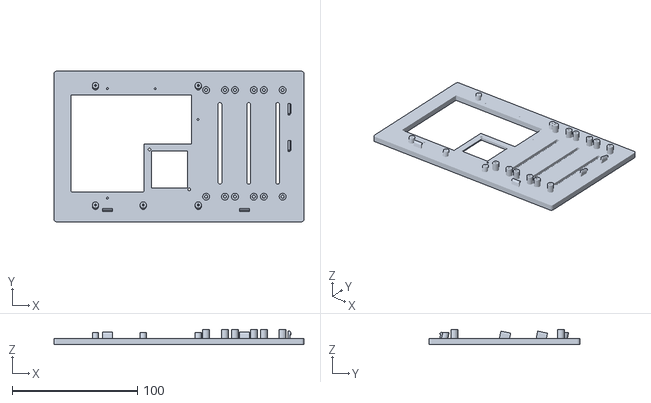
[picture p12: CAD file, 2026-10-31]
hardware/case/export/makropad_lid.stl
199.2 x 120.0 x 12.0
