SiDu01/MakroPad/hardware/case/export/makropad_oled_frame.stl

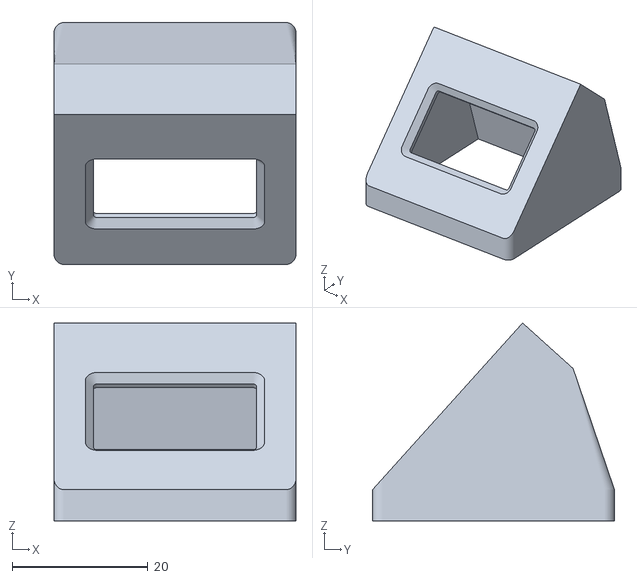
[picture p13: CAD file, 2026-10-10]
hardware/case/export/makropad_oled_frame.stl
35.6 x 35.6 x 29.1
