SiDu01/MakroPad/hardware/case/export/makropad_switch_plate.stl

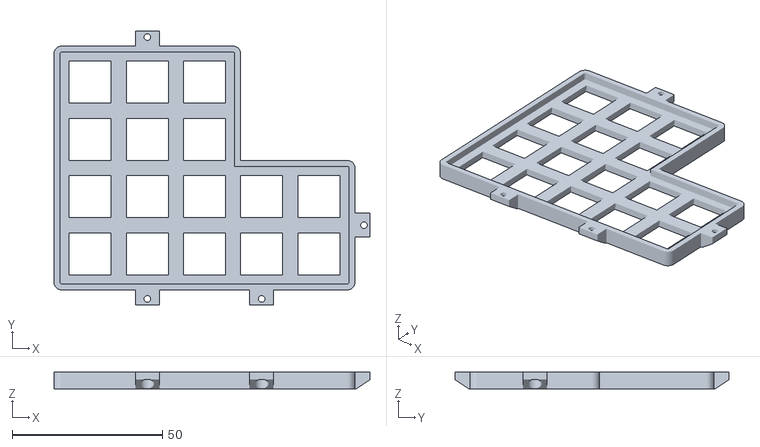
[picture p14: CAD file, 2026-10-10]
hardware/case/export/makropad_switch_plate.stl
105.2 x 91.2 x 5.50
