SiDu01/MakroPad/(list of files, cad)

Other CAD files:
hardware/case/export/makropad_keycap_sla.stl
