SiDu01/MakroPad/hardware/case/export/preview_assembly.png

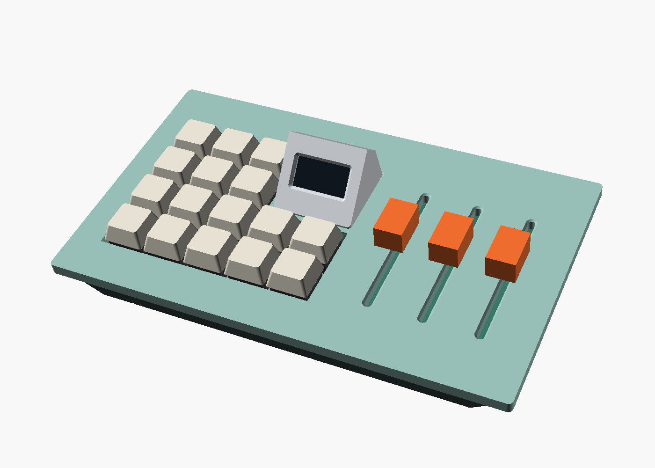
hardware/case/export/preview_assembly.png
