SiDu01/MakroPad/hardware/schematic/makropad.pdf

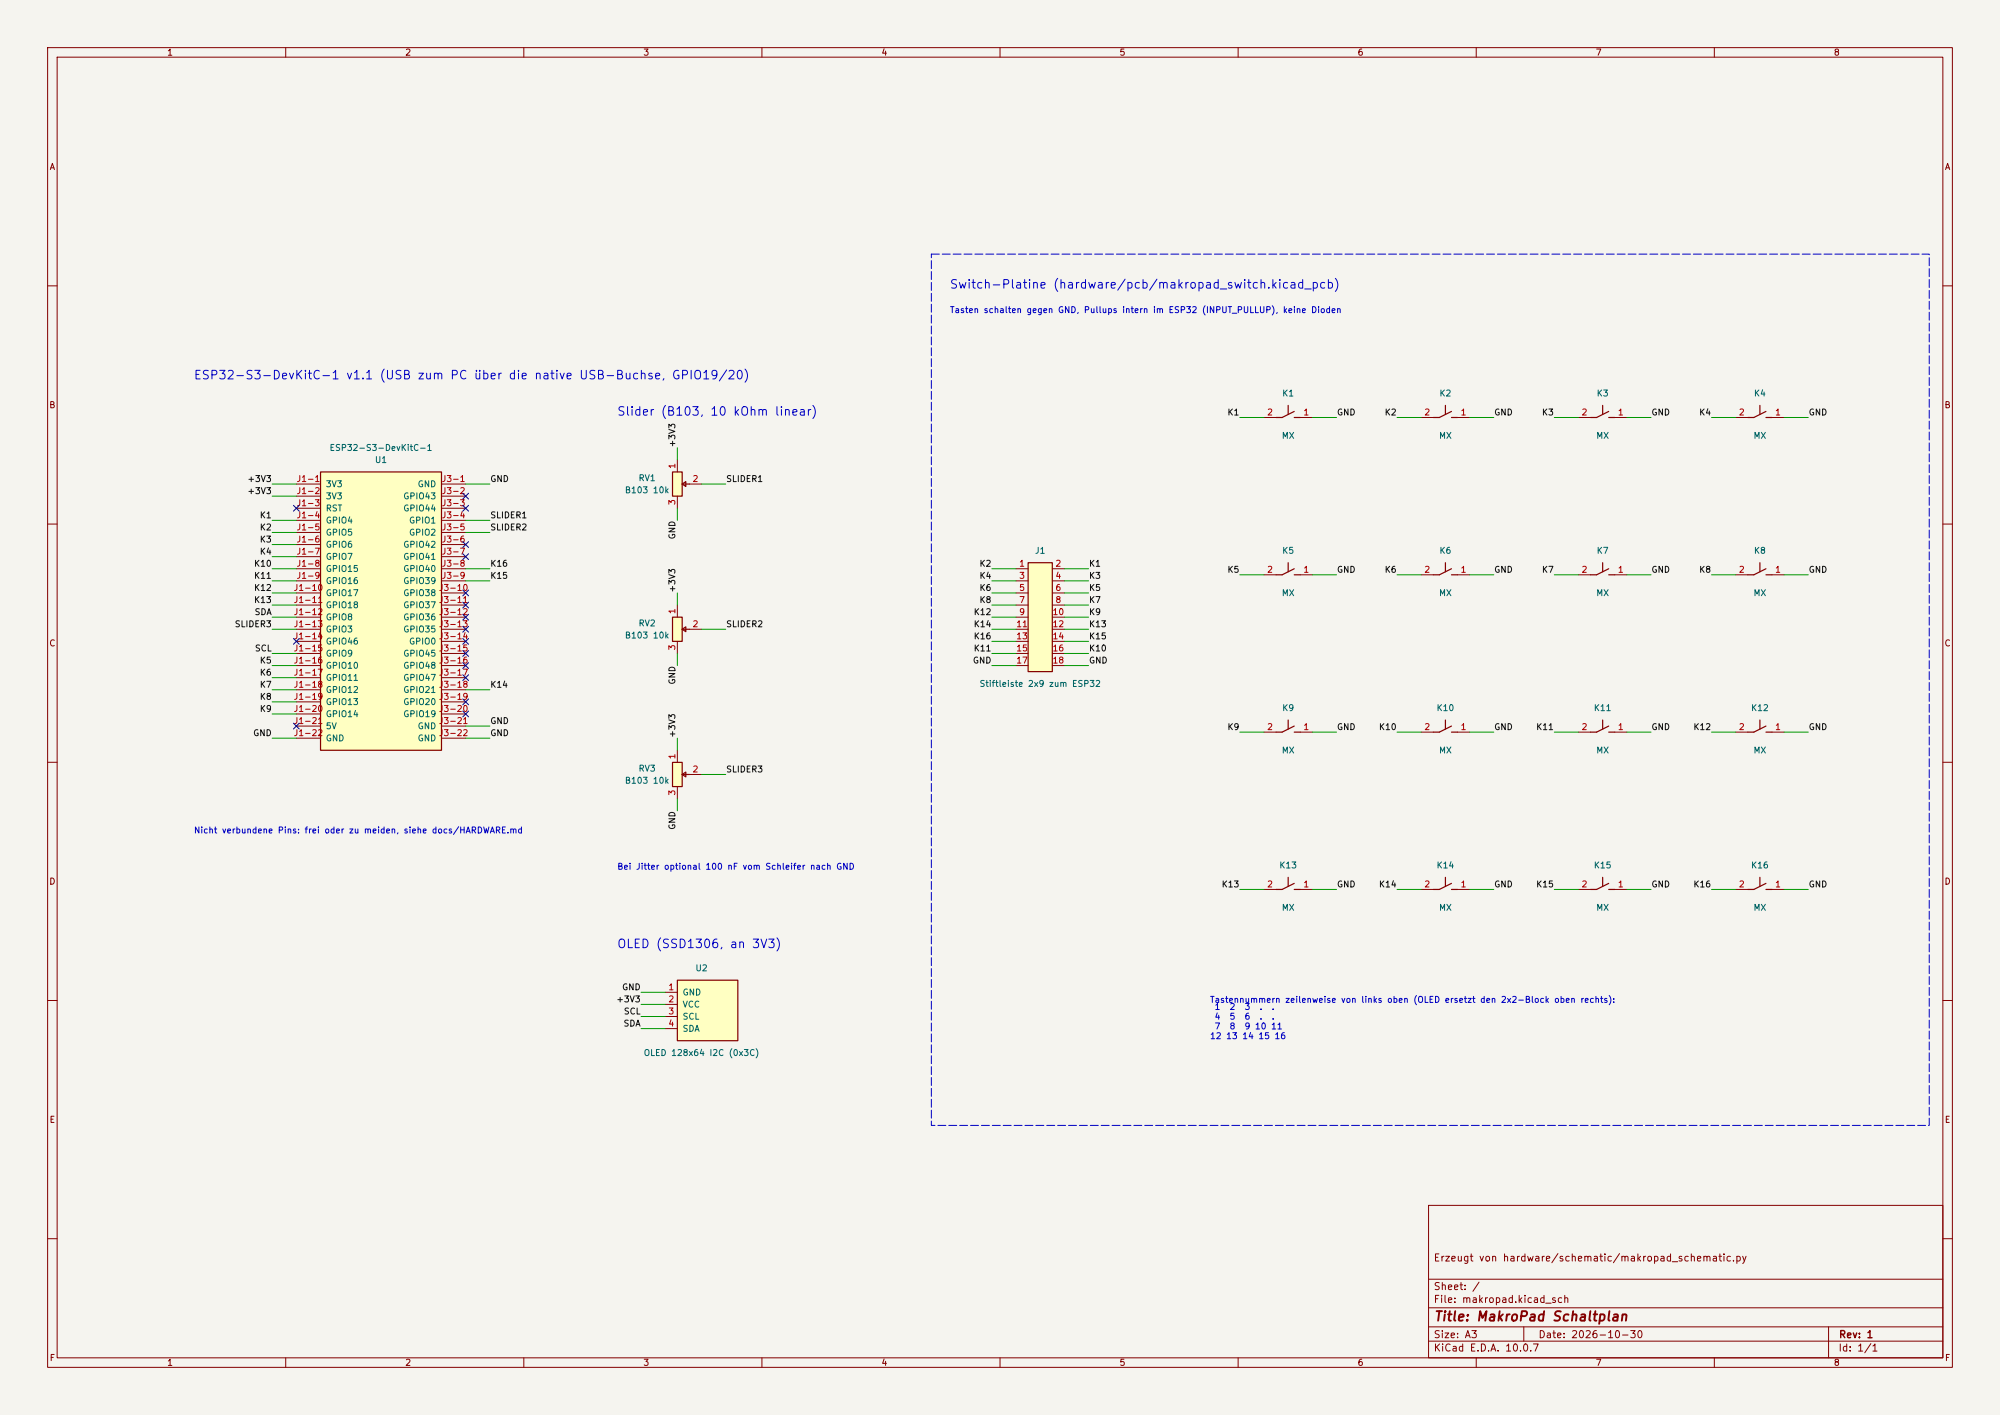
[picture p16: page 1]

Switch-Platine (hardware/pcb/makropad_switch.kicad_pcb)

Tasten schalten gegen GND, Pullups intern im ESP32 (INPUT_PULLUP), keine Dioden Bei Jitter optional 100 nF vom Schleifer nach GND

ESP32-S3-DevKitC-1 v1.1 (USB zum PC über die native USB-Buchse, GPIO19/20)

SDA Nicht verbundene Pins: frei oder zu meiden, siehe docs/HARDWARE.md

Tastennummern zeilenweise von links oben (OLED ersetzt den 2x2-Block oben rechts):

Erzeugt von hardware/schematic/makropad_schematic.py

Size: A3 | Rev: 1 | F Date: 2026-10-30
KiCad E.D.A. 10.0.7 | Id: 1/1
