SiDu01/MakroPad/hardware/pcb/makropad_switch.kicad_pcb

## KiCad design hardware/pcb/makropad_switch.kicad_pcb (2026-10-29)

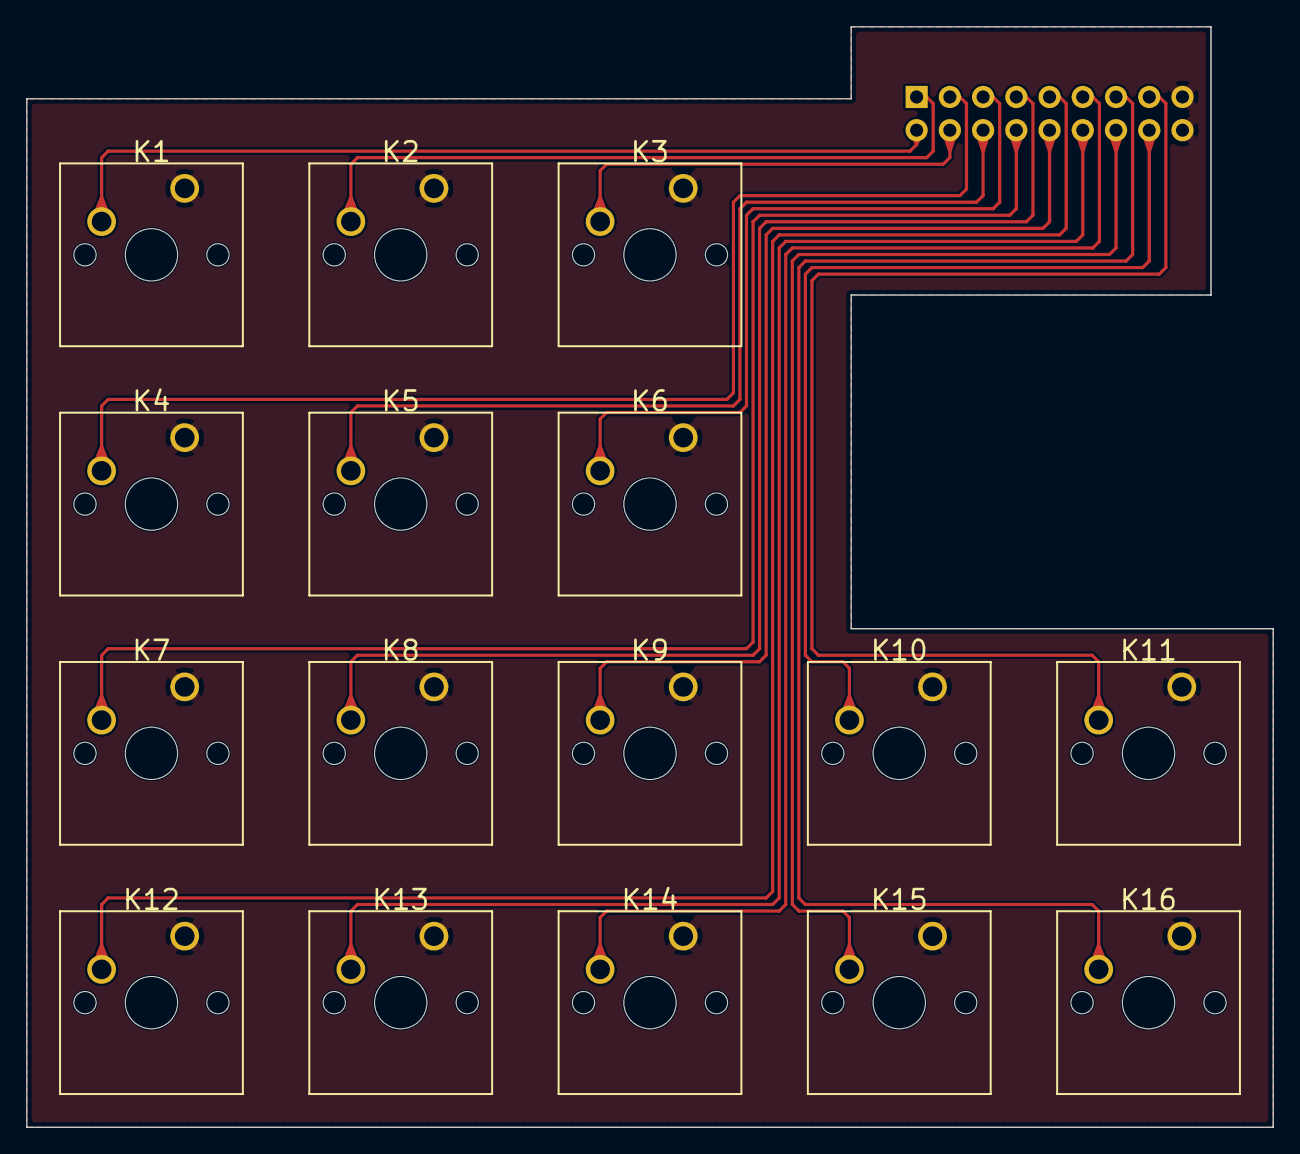
[picture p17: board makropad_switch.kicad_pcb from above]

Board: 2 copper layers, 95.2 x 84.1 mm, 17 parts (1 on the bottom side), 17 nets.

Parts:
J1: to ESP32; PinHeader_2x09_P2.54mm_Vertical
K1, K2, K3, K4, K5, K6, K7, K8, K9, K10, K11, K12, K13, K14, K15, K16: MX; SW_Cherry_MX_1.00u_PCB

Connections:
GND: J1.17, J1.18, K1.1, K2.1, K3.1, K4.1, K5.1, K6.1, K7.1, K8.1, K9.1, K10.1, K11.1, K12.1, K13.1, K14.1, K15.1, K16.1
K1: J1.2, K1.2
K2: J1.1, K2.2
K3: J1.4, K3.2
K4: J1.3, K4.2
K5: J1.6, K5.2
K6: J1.5, K6.2
K7: J1.8, K7.2
K8: J1.7, K8.2
K9: J1.10, K9.2
K10: J1.16, K10.2
K11: J1.15, K11.2
K12: J1.9, K12.2
K13: J1.12, K13.2
K14: J1.11, K14.2
K15: J1.14, K15.2
K16: J1.13, K16.2
