SiDu01/MakroPad/firmware/src/input.cpp

#include "input.h"

#include <Arduino.h>

#include "button_combo.h"
#include "config.h"
#include "debouncer.h"
#include "hid.h"
#include "hostlink.h"
#include "protocol.h"
#include "slider_filter.h"

using makropad::LineBuilder;

namespace input {

namespace {

makropad::Debouncer buttons[config::ButtonCount];
makropad::ButtonCombo channelCombo(config::ChannelSwitchHoldButton, config::ChannelSwitchButton);
makropad::SliderFilter sliders[config::ActiveSliderCount];
uint32_t lastSliderPollMs = 0;

int readSliderRaw(uint8_t pin) {
  int samples[config::SliderSampleCount];
  for (uint8_t index = 0; index < config::SliderSampleCount; index++) {
    samples[index] = analogRead(pin);
    delayMicroseconds(150);
  }
  // The pots are wired so the top end reads 0; flip it so top means 1000.
  return 4095 - makropad::trimmedMean(samples, config::SliderSampleCount, 5);
}

}  // namespace

void setup() {
  for (size_t index = 0; index < config::ButtonCount; index++) {
    buttons[index] = makropad::Debouncer(config::DebounceMs);
    pinMode(config::ButtonPins[index], INPUT_PULLUP);
  }
  analogReadResolution(12);
}

void poll(uint32_t nowMs) {
  for (size_t index = 0; index < config::ButtonCount; index++) {
    const bool pressed = digitalRead(config::ButtonPins[index]) == LOW;
    if (!buttons[index].update(pressed, nowMs)) {
      continue;
    }
    makropad::ButtonCombo::Event events[2];
    size_t count = 0;
    if (channelCombo.update(static_cast<uint8_t>(index + 1), pressed, events, count)) {
      hostlink::switchChannel(nowMs);
    }
    for (size_t event = 0; event < count; event++) {
      const long id = events[event].id;
      const bool down = events[event].pressed;
      hostlink::send(LineBuilder("button").add("id", id).add("state", down ? "down" : "up").str());
      hid::onButton(events[event].id, down, nowMs);
    }
  }

  if (nowMs - lastSliderPollMs < config::SliderPollIntervalMs) {
    return;
  }
  lastSliderPollMs = nowMs;

  for (size_t index = 0; index < config::ActiveSliderCount; index++) {
    if (!sliders[index].update(readSliderRaw(config::SliderPins[index]), nowMs)) {
      continue;
    }
    const uint8_t id = static_cast<uint8_t>(index + 1);
    const int value = sliders[index].normalized();
    hostlink::send(LineBuilder("slider").add("id", static_cast<long>(id)).add("value", static_cast<long>(value)).str());
    hid::onSlider(id, value, nowMs);
  }
}

}  // namespace input
