SiDu01/MakroPad/(commit log)

2026-05-14 Add serial device connection
2026-05-14 Extract action pipeline and throttle sliders
2026-05-29 Mirror firmware serial over UART
2026-06-02 Extract device display sync service
2026-06-04 Stabilize firmware slider readings
    [MakroPadFirmware.ino]
2026-06-04 Throttle HID fallback volume nudges
2026-06-13 Split MainWindow into section views and add theme system
    Break the monolithic MainWindow.axaml into seven focused section views
    (Macros, Device, Simulation, ProfilesSettings, ApplicationSettings,
    DisplayEditor, Debug) bound to the shared MainWindowViewModel, with a
    reusable PageHeader control. Move shortcut recording and the open-app
    file picker into MacrosView.
    Add a runtime light/dark theme system (AppTheme themed brushes, NavIcons
    geometries, FluentTheme palettes, IsDarkTheme/ToggleTheme) and a MakroPad
    app icon. Update README and HANDOFF.
2026-06-13 Add unit tests for Spotify window title parsing
    Expose ParseSpotifyWindowTitle so the pure parsing logic can be covered
    directly, and add tests for valid artist/title parsing, whitespace
    trimming, embedded separators in track titles, ignored idle/ad titles,
    and unparseable inputs.
2026-06-13 Add device-centric shell with workflow-ordered navigation
    Introduce ShellViewModel (inherits the existing app runtime orchestration
    from MainWindowViewModel) plus a new Shell window with a left navigation
    rail ordered by workflow: Pad, Display, then a System group with
    Verbindung, Einstellungen, Diagnose. Sections are placeholder views for
    now and share the shell as data context, toggled by Is*Selected.
    Add nav-rail / nav-item theme styles and Pad/Connection/Settings/
    Diagnostics nav icons. Launch the Shell instead of MainWindow; the old
    views and MainWindowViewModel remain until the rebuild completes.
2026-06-13 Build device-centric Pad grid with edit/test modes
    Add PadViewModel with 20 key tiles and 3 slider strips mapped to the
    active profile's bindings via ProfilesEditorViewModel. Edit mode selects a
    slot for editing; Test mode simulates the input. A new InputActivated
    event on the runtime (raised for hardware and simulator inputs) pulses the
    matching tile. The Pad header carries a segmented Edit/Test toggle and a
    profile bar (switch + add/rename/delete flyout). Adds key-tile, slider-
    strip, segment and inspector styles. Inspector shows the selected slot;
    the full binding editor follows.
2026-06-13 Add contextual binding editor to the Pad inspector
    Wire the inspector to the existing action editor: action picker, structured
    and raw parameters, hints, validation, shortcut recorder and app/file
    picker. Save adds or updates the selected slot's binding; Leeren removes it.
    Shortcut recording is captured by a window-level tunnel handler on the
    Shell; the open-app file picker lives in PadView code-behind.
2026-06-13 Build Display designer with persistent OLED preview
    Reorganize the display editor into the new rhythm: idle-screen settings and
    the ordered rule list on the left, the selected-rule editor in the centre,
    and a persistent right column with the live idle and selected-rule OLED
    previews plus runtime options. Reuses DisplaySettings/DisplayTriggersEditor.
    Add a global Speichern button to the shell nav footer so binding and display
    changes persist to config.json.
2026-06-13 Remove legacy views and finalize device-centric rebuild
    Delete the old section views (Macros, Device, Simulation, ProfilesSettings,
    ApplicationSettings, DisplayEditor, Debug), the MainWindow and the PageHeader
    control. Merge MainWindowViewModel into ShellViewModel (split into
    ShellViewModel.cs for navigation and ShellViewModel.Runtime.cs for the app
    orchestration). Add PadViewModel unit tests (slot mapping, edit/test mode,
    save/clear). Update README and HANDOFF.
2026-06-13 Make pad layout configurable (button rows/columns, slider count)
    Add ButtonRows/ButtonColumns/SliderCount to AppSettingsConfig and a Pad-
    Layout card in Settings. PadViewModel.ApplyLayout rebuilds the key grid
    (rows*columns, numbered button:1..N) and slider strips; the grid columns
    bind to the configured value. The shell loads the layout on config load and
    writes it on save. Adds ApplyLayout unit tests.
2026-06-13 Split Display into an overview and a dedicated rule editor page
    Display now opens on an overview: idle-screen settings, the rule list with
    "Regel erstellen" and the persistent idle OLED preview/runtime. Creating or
    editing a rule (button or double-tap) navigates to a separate single-rule
    page with the full editor and its live preview, plus a back button.
    ShellViewModel gains IsDisplayEditorOpen and create/edit/close commands;
    leaving Display resets to the overview.
2026-06-13 Add real HTML subset parser and Markdown content mode
    Replace the regex-based "html-like" renderer with a proper tokenizer that
    handles a documented, device-appropriate subset: h1/h2 (size 2), h3-6/p/div/
    section/header/tr blocks, br, hr (divider), ul/ol/li (bulleted/numbered),
    nesting, inline tags kept as text, and entity decoding. Add a new "markdown"
    content mode (# heading, - / * list, --- divider, blank lines dropped) that
    flows through RenderTemplateLines and the live preview. Both modes are
    selectable per rule, with a Markdown preset. Adds Core renderer tests.
2026-06-14 Add visual block builder for the Markdown content mode
    In the rule editor, Markdown rules can switch between the raw text area and a
    "Baukasten" block editor: stack heading/text/list/divider blocks, reorder or
    remove them, and insert placeholders from a menu. Blocks parse from and
    serialize back to the same Markdown template, so the live OLED preview and
    global save keep working unchanged. Adds DisplayBlockViewModel and parse/
    serialize round-trip tests.
2026-06-14 Add idle-screen config model, rendering and migration
    Introduce IdleScreenConfig (name, enabled, template, mode, activation,
    process) and AppSettings fields (IdleScreens, IdleScreensInitialized,
    IdleRotationSeconds). Migration synthesizes a "Standard" idle screen from the
    existing Hardware.Display default fields on first load. Add
    DisplayTriggerRenderer.RenderContentLines (mode-aware, keeps placeholders for
    device, used for previews too) and extract the block parse/serialize into a
    shared DisplayBlockMarkup helper now used by the rule editor. Adds tests.
2026-06-14 Add idle-screen orchestrator and process presence probe
    IdleScreenOrchestrator selects the active idle screen each tick: process
    screens whose process runs take priority over default screens; more than one
    active screen rotates every IdleRotationSeconds; falls back to any enabled
    screen. Selection/rotation are a pure Evaluate(now) for testing; a
    DispatcherTimer drives it live and fires a callback on change.
    ProcessPresenceProbe checks running processes via Process.GetProcessesByName.
2026-06-14 Drive the device idle screen from the orchestrator
    The config send now builds its default-screen lines from the active idle
    screen (rendered app-side, placeholders kept) instead of the single
    structured default. The shell configures and starts the orchestrator on
    config load and sends config whenever the active screen changes (process
    match or rotation). RenderDeviceLines no longer injects {profile}/{status}/
    MakroPad fallbacks, so freeform idle screens render exactly as authored.
2026-06-14 Test idle editor and document idle screens and content modes
    Add IdleScreensEditor load/export and live-edit tests; document the new idle
    screens, switching and content modes (HTML subset, Markdown, block builder)
    in README and HANDOFF.
2026-06-14 Remove dead default-screen fields from DisplaySettings
    DisplaySettingsViewModel is now runtime-only (Now Playing, action-result
    timeout, volume deadband); the structured default-screen fields, OLED preview
    properties and CreateDeviceDisplayState are gone now that idle screens own that
    content. Drop the matching dead path: DeviceDisplaySyncService.RenderPreview/
    UsesMediaPlaceholder, OledDefaultScreenRenderer.RenderPreview overloads and the
    OledDefaultScreenPreview record, plus a leftover unused const/using in the
    renderer. Trim the DisplaySettings tests accordingly.
2026-06-14 Support blank lines and per-line alignment in markdown content
    DisplayTemplateLine gains an Alignment (left/center/right). The Markdown
    renderer now keeps blank lines as empty OLED rows and reads a leading
    "[c]"/"[r]"/"[l]" tag to set the line alignment. The preview pads centered and
    right-aligned lines with spaces so the editor preview matches the device.
2026-06-14 Add blank-line and alignment blocks to the Baukasten
    The block builder gains a "Leerzeile" block and a per-block alignment selector
    (left/center/right). DisplayBlock(Markup) carries alignment and a blank kind,
    round-tripping with the "[c]"/"[r]" tags and empty lines in the template. Both
    the rule and idle editors expose the new block button and alignment dropdown.
2026-06-14 Send per-line alignment to the device and simplify the config path
    DeviceDisplayState now carries the rendered DefaultLines (text+size+align)
    instead of flat fields. The config message sends defaultTitleAlign/
    defaultLineNAlign (omitted when left) and always mode "normal" since content is
    rendered app-side; temporary template messages send lineNAlign too. Drops the
    now-unused RenderDeviceLines/HTML/preview helpers from OledDefaultScreenRenderer.
2026-06-14 Render per-line text alignment on the device
    Add left/center/right alignment to the firmware text-line renderer: config
    (defaultTitleAlign/defaultLineNAlign) and display template (lineNAlign) carry
    the alignment, and short non-scrolling lines are offset accordingly; long
    scrolling lines stay left. Blank lines are preserved as empty rows. Document
    the new align fields in PROTOCOL.md.
    Note: firmware change — requires an Arduino flash and a hardware test on the
    ESP32-S3; app-side alignment/blank-line authoring and preview already work.
    [MakroPadFirmware.ino]
2026-06-14 Fix blank-line handling in firmware idle/template rendering
    Empty default-screen fields are intentional blank lines from the app, so the
    config handler now overwrites title/line1/line2 unconditionally (matching
    line3/line4) instead of skipping empty values, which left a stale duplicate of
    the previous line. The display template handler keeps intermediate blank lines
    and only trims trailing empty ones, instead of collapsing all blanks.
    Note: firmware change — requires an Arduino flash and a hardware test.
    [MakroPadFirmware.ino]
2026-06-14 Switch the app palette from blue to gray-teal
    Replace the blue/navy accent and surfaces with neutral gray surfaces and a
    teal accent (dark #2DD4BF, light #0D9488) across both themes, including the
    FluentTheme palettes, OLED preview frame/glow and primary hover. Add a
    theme-aware AppAccentForegroundBrush so text on the accent stays readable
    (dark text on the brighter dark-theme teal, white on the darker light-theme
    teal).
2026-06-20 Bring docs up to date with the current app state
    Update PROJECT_PLAN (device-centric UI, configurable pad layout, idle screens,
    content modes/alignment; drop the done MainWindowViewModel split), DISPLAY_DESIGN
    (multiple idle screens with activation/rotation, overview + editor pages,
    content modes/alignment), TODO (MainWindowViewModel split done), HANDOFF (date,
    device-centric/gray-teal current state, 0.1.0 release and theme milestones,
    firmware flashed, ShellViewModel naming) and README (firmware idle screen
    wording, theme and 0.1.0 release).
2026-06-21 Add condition-based idle-screen activation and tray-start option
    Idle screens now activate on a list of conditions instead of the old
    default/process toggle:
    - Condition types: processRunning, processForeground, fullscreen,
    mediaActive and systemMetric (cpu/memory/battery/network), each
    optionally negated and combined via and/or.
    - Behaviour per screen: priority tiers, exclusive (show alone) and
    anti-flicker (activation-delay + min-dwell), evaluated each second by
    IdleScreenOrchestrator against a SystemStateSnapshot.
    - SystemStateProvider feeds the snapshot: running processes, media-active
    audio sessions (ApplicationAudioSession.IsActive), foreground/fullscreen
    via WindowsForegr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
2026-10-04 Add PlatformIO firmware skeleton, protocol v2 and 16-key pinout
    Firmware is now a PlatformIO project with central config.h and a
    host-tested slider filter in lib/makropad_core. Docs describe protocol v2
    and the final 16-key hardware.
2026-10-04 Add .NET 10 solution skeleton for the rewrite
    Core (protocol codec + tests), Device, Windows and Avalonia App projects
    with shared Directory.Build.props and an SDK 10 global.json. Rebuilt the
    app icon from the PNG since the legacy .ico was empty.
2026-10-04 Add parametric OpenSCAD case with STL exports
    [makropad_case.scad, makropad_lid.stl, makropad_oled_frame.stl, makropad_switch_plate.stl, makropad_tray.stl]
2026-10-04 Port firmware modules for protocol v2
    hostlink (handshake, heartbeat, dispatch), input (debounced buttons,
    filtered sliders normalized to 0..1000), display (fixed idle screen with
    running clock plus volume/action/media/profile/status overlays, marquee,
    CP437 umlauts) and the HID consumer-control fallback. Pure logic lives in
    lib/makropad_core with 20 native tests.
    [config.h, display.cpp, display.h, hid.cpp, hid.h, hostlink.cpp, hostlink.h, input.cpp]
2026-10-04 Add app runtime core, serial/simulator connection and Windows actions (M1)
    DeviceSession handles the v2 handshake, heartbeat and input parsing on top
    of a line transport. MakroPadRuntime reconnects automatically, routes inputs
    (slider deadband, latest-wins execution) to actions and sends OLED feedback.
    Serial auto-detection, a simulated device, media-key and system-volume
    actions, and a minimal status/log window with --simulator mode.
2026-10-04 Add config, profiles, new actions and tray (M2)
    config.json (schema 1) is validated against a central ActionCatalog,
    reloaded live and never overwritten; a broken file keeps defaults active.
    App-owned state (active profile, last port) lives in state.json. Legacy
    0.2 configs are archived. New actions: app.volume, keyboard.shortcut,
    system.openUrl, system.openApp, profile.next/set. OLED feedback can be
    switched off per event type. Tray icon with profile menu, start in tray
    and Windows autostart.
2026-10-04 Add device-centric editor UI with live OLED mirror (M3)
    The pad page draws the MakroPad from above in its printed colours; keys,
    faders and the display are selectable and edited in an inspector that saves
    immediately. OledMirror re-implements the firmware's display rendering with
    the Adafruit 5x7 font so the preview matches the device pixel for pixel.
    Profile bar, diagnostics (connection, config problems, audio sessions,
    protocol log, simulator) and settings (start, theme, slider tolerance).
    ConfigService.Save ignores its own writes in the file watcher.
2026-10-04 Record shortcuts with a low-level keyboard hook
    Window key events never see combinations Windows handles itself (Win+E,
    Win+R ...). Recording now uses a WH_KEYBOARD_LL hook that is active only
    while recording, swallows the keys so nothing is triggered, and cancels on
    Esc. Key-to-text formatting lives in ShortcutParser with tests.
2026-10-04 Run the shortcut recorder hook on its own thread
    Windows skips and eventually removes low-level hooks whose thread does not
    answer quickly, so a busy UI thread let Win+E through. The hook now has a
    dedicated thread with its own message loop, also records injected keys
    (keyboard software re-injects presses) and logs to the diagnostics page.
    Adds a --selftest-recorder development aid that drives the inspector.
2026-10-04 Add now playing, automatic profiles and foreground volume (M4)
    MediaSessionWatcher follows the Windows media session (GSMTC) for any
    player; the runtime puts artist and title on the idle screen and shows a
    short overlay on track changes. ForegroundWatcher and AutoProfileSwitcher
    activate profiles by foreground program with an optional fallback; a manual
    choice stays until the program changes and the app's own window is ignored.
    Rules are edited on the settings page. New actions app.volume.foreground and
    app.volume.others.
2026-10-04 Show the track title large above the artist and only while playing
    While music plays the idle screen moves the clock into the header and shows
    the title at size 2 above the artist; the media overlay uses the same
    layout (firmware and OLED mirror). Paused or stopped playback returns to
    clock and date after a 2 s grace period that bridges track skips; resuming
    the same track does not repeat the overlay.
    [display.cpp]
2026-10-10 Survive the serial read being cancelled at shutdown
    Windows cancels the pending read when the port goes away, which threw an unhandled OperationCanceledException on the read thread and crashed the app on every PC shutdown.
2026-10-10 Mount the OLED in an angled housing and rotate the image
    The display now sits upside down at 60 degrees in a wedge housing, so the firmware rotates it by 180 degrees.
    [makropad_case.scad, makropad_lid.stl, makropad_oled_frame.stl, makropad_switch_plate.stl, makropad_tray.stl]
2026-10-16 Fit the 64 mm ESP32 board and add an adapter for printed trays
    The cradle now matches the measured 64 mm board. esp_adapter lets a tray
    already printed for the 74 mm board hold the shorter one.
    [makropad_case.scad, makropad_esp_adapter.stl, makropad_tray.stl]
2026-10-16 Hide test aids behind a debug mode and enable all sliders
    Command-line test options (simulator, screenshots, recorder self-test,
    config dir) and recorder traces now require debugMode, switchable under
    Settings > Entwicklermodus; the diagnostics page then lists the options.
    Replace obsolete TextBox.Watermark with PlaceholderText, dispose the pause
    timer on shutdown, and activate sliders 2 and 3 in the firmware.
    [config.h]
2026-10-16 Document the ESP32-S3-DevKitC-1 header pinout with MakroPad assignments
2026-10-16 Add long/double press, macros, text input, commands and HTTP requests (M5 core)
    GestureDetector turns key down/up into button:N, button:N:long and
    button:N:double; keys without gesture bindings still fire on key down.
    ActionRunner runs macro steps with delays and stops at the first failure.
    New actions keyboard.text (Unicode typing), system.run (hidden cmd with
    exit code check) and http.request. Validation covers gesture inputs, macro
    steps and HTTP parameters; renaming a profile updates macro steps.
2026-10-28 fix: name icon-only step buttons and bound gesture tabs for screen readers
    The macro step buttons only showed arrows and a cross, so screen readers
    announced the symbols instead of the action. A bound gesture was marked
    by a dot alone, which screen readers cannot see.
2026-10-28 fix: release the device on exit without blocking the UI thread
    Shutdown waited synchronously on the runtime, which can deadlock on the
    UI thread, and the tray's "Beenden" skipped cleanup entirely because a
    forced shutdown never raises ShutdownRequested. All exits now go through
    one async path with a two-second limit for the device.
    The developer aids move to App.DevTools.cs; the recorder self-test cast
    the key inspector to the pre-M5 type and failed, which is fixed there.
2026-10-28 fix: keep lines to the device within the firmware's 256-byte limit
    The firmware drops longer lines entirely. A long track title made the
    whole state line fail, so the display lost profile and clock until the
    track changed. Long track texts are now shortened instead.
2026-10-28 fix: ping the device when the app has been quiet
    The firmware times out after 6 s without app messages, but the app only
    pinged after device silence. A device that keeps sending (e.g. a noisy
    slider) fell back to HID mode and reconnected in a loop.
2026-10-28 fix: report save errors instead of crashing
    A read-only config.json threw UnauthorizedAccessException out of the
    editor, and a locked state.json (virus scanner, OneDrive sync) crashed
    the app on profile switch. State is kept in memory and the failure is
    shown as a warning in the diagnostics.
2026-10-28 feat: show device error messages as warnings in the diagnostics
    Errors such as display_init_failed only appeared as raw protocol lines
    and disappeared when the device filter was off.
2026-10-28 fix(firmware): report active sliders and stop blocking on HID taps
    hello announced all slider pins even when fewer are wired. A HID key
    tap held the main loop for 30 ms; the key is now released in poll().
    [hid.cpp, hostlink.cpp]
2026-10-28 feat: switch off single keys, sliders and the display
    Unwired or unwanted inputs can be ignored in all profiles via
    settings.disabledInputs, and settings.displayEnabled turns the OLED off
    through a new display message. The firmware switches the display back
    on when the app disconnects, so the fallback stays visible; older
    firmware ignores the message.
2026-10-28 chore: update graphify graph after disable switches
2026-10-29 feat: add a toggle action that runs the next step on each press
    Keys often switch something on and off (camera, mute, a scene). The
    toggle action reuses the macro step list and editor; a failed step is
    tried again on the next press, and the position resets when the config
    reloads.
2026-10-29 feat: add generated switch PCB for the 16 MX keys
    Replaces hand wiring under the switch plate: each key gets its own trace
    to a 2x9 header next to the ESP32, matching config::ButtonPins without
    firmware changes. The board is generated from the case dimensions so it
    stays in sync with makropad_case.scad; Gerbers are exported for JLCPCB.
    [makropad_switch-B_Cu.gbl, makropad_switch-B_Mask.gbs, makropad_switch-B_Silkscreen.gbo, makropad_switch-Edge_Cuts.gm1, makropad_switch-F_Cu.gtl, makropad_switch-F_Mask.gts, makropad_switch-F_Silkscreen.gto, makropad_switch-NPTH-drl_map.gbr]
2026-10-29 chore: update graphify graph after switch PCB
2026-10-29 feat: apply Wuerth Elektronik basic design rules to switch PCB
    The board should be manufacturable under Wuerth's BASIC STANDARD rules
    (04/2023, 1 oz foil), not only at JLCPCB's looser limits. The rules are
    stored as board constraints so KiCad's DRC enforces them; teardrops and
    the legend-to-copper distance are handled by the generator because
    KiCad covers neither from the CLI.
    [makropad_switch-B_Cu.gbl, makropad_switch-B_Mask.gbs, makropad_switch-B_Silkscreen.gbo, makropad_switch-Edge_Cuts.gm1, makropad_switch-F_Cu.gtl, makropad_switch-F_Mask.gts, makropad_switch-F_Silkscreen.gto, makropad_switch-NPTH-drl_map.gbr]
2026-10-29 chore: update graphify graph after PCB design rules
2026-10-29 refactor: route switch PCB tracks with 45 degree corners
    90 degree bends are harmless for these slow key signals, but 45 degree
    corners are the common layout convention and shorten the traces
    slightly. Corners are chamfered in the generator so regenerating the
    board keeps them.
    [makropad_switch-B_Cu.gbl, makropad_switch-B_Mask.gbs, makropad_switch-B_Silkscreen.gbo, makropad_switch-Edge_Cuts.gm1, makropad_switch-F_Cu.gtl, makropad_switch-F_Mask.gts, makropad_switch-F_Silkscreen.gto, makropad_switch-NPTH-drl_map.gbr]
2026-10-31 feat: move ESP32 under the sliders and stiffen the case tray
    The ESP32 did not leave enough room for the switch wiring under the keys
    and the display. It now lies flat along the back wall under the sliders,
    USB-C out of the right wall, with about 10 mm free above it. Headers are
    desoldered and wires go straight into the pads.
    - Add a fifth lid screw at the back left, move all screw pillars inward
    so their head channels no longer cut into the bottom facets, and tie
    each pillar to the wall with a web.
    - Widen the ESP side guides towards the floor so they do not snap off.
    - Move the rear right snap hook away from the USB cut-out.
    - Drop the ESP adapter, which only fit the old tray.
    Co-Aut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
    [makropad_case.scad, makropad_esp_adapter.stl, makropad_lid.stl, makropad_tray.stl]
2026-10-31 feat: add parametric MX keycap for FDM and SLA printing
    Blank flat keycap with a shallow dish and an MX cross whose clearance is
    picked per printer, so the 16 caps can be printed instead of bought.
    [makropad_keycap.scad, makropad_keycap_fdm.stl, makropad_keycap_sla.stl]
2026-10-31 feat: add generated wiring schematic
    The schematic is generated from a Python script that takes the pinout
    from the firmware config and the header order from the switch PCB, so it
    stays in sync with both. The exported PDF is included for quick viewing.
    [makropad.kicad_sch]
2026-10-31 chore: update graphify graph after case and schematic changes
2026-10-31 fix: flip slider readings so the top end means 100 %
    The pots are wired so the top end reads 0, which made both the app
    display and volume run the wrong way.
    [input.cpp]
2026-10-31 fix: swap button pins 4/13 and 10/12 to match the wiring
    Those keys were wired to each other's pins, so pressing one fired the other.
    [config.h]
2026-10-31 feat: add setting to invert all sliders
    Lets pads with pots wired the other way round be fixed without reflashing.
2026-10-31 chore: update graphify graph after slider and pin changes
2026-11-03 feat: connect the app over Bluetooth LE
    The pad can now talk to the app without a USB data cable. The firmware
    offers the line protocol over the Nordic UART Service next to USB CDC;
    the channel that receives hello-ack becomes the only one. Access needs
    an encrypted, bonded link with a passkey shown on the OLED, because a
    connected client can trigger shortcuts and HTTP requests in the app.
    The app tries USB first, then paired BLE devices.
    [ble.cpp, ble.h, config.h, display.cpp, display.h, hostlink.cpp, hostlink.h]
2026-11-03 fix: give USB priority over Bluetooth
    With one PC on Bluetooth and another on USB, the bonded Bluetooth link
    reconnected right after boot and won the handshake, since the device
    stopped sending hello once connected. A late Bluetooth hello-ack could
    also take over a USB connection.
    The device now keeps offering hello on USB while connected over
    Bluetooth, lets a USB hello-ack take over, and never lets a Bluetooth
    hello-ack replace USB.
    [hostlink.cpp]
2026-11-03 feat: switch between USB and Bluetooth with buttons 12+11
    Automatic USB priority does not cover every setup, so holding button
    12 and pressing 11 pins the connection to the other channel until the
    next switch or reboot. The OLED shows the new channel.
    Button 12 is held back until release so the combo triggers no action;
    it therefore loses its long press.
    [config.h, hostlink.cpp, hostlink.h, input.cpp]
2026-11-03 chore: update graphify graph after channel switching
